of-dandelions-and-daisies/basics-of-mechatronics/mechanical/CAD/Final/kcd4_v1.jpg

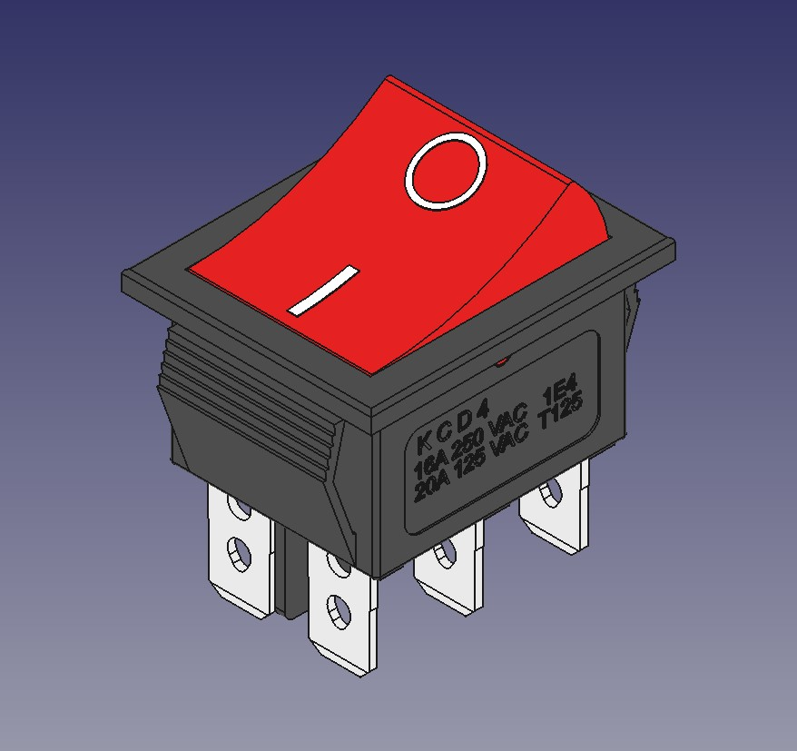
mechanical/CAD/Final/kcd4_v1.jpg
