of-dandelions-and-daisies/basics-of-mechatronics/app/README.md

# App

Processing IO application for the mechatronics project.
