of-dandelions-and-daisies/basics-of-mechatronics/docs/Actuator_Sizing_Report.docx

Actuator Sizing Report

Automated Ball Sorting & Shooting System

MCT231: Basics of Mechatronics | Ain Shams University | June 2026

# 1. Introduction

This report presents the complete actuator sizing analysis for the three mechatronic subsystems of the Automated Ball Sorting & Shooting System. Each actuator is sized using peak and RMS torque/speed requirements derived from the trapezoidal velocity profiles and projectile motion constraints defined in the Product Design Specification (PDS Rev 1.0).

The system contains three actuators:

Subsystem | Actuator type | Key output | Drive
Lifting mechanism | High-torque servo / stepper | 0.5 m/s belt speed | PWM pin 9
Shooting mechanism | N20 DC gear motor | ~400 rpm / 2.7 m/s | L298N + pins 12/13/6
Sorting mechanism | SG90 micro servo | 45° gate sweep | PWM pin 0

# 2. Lifting Mechanism

Belt-drive servo / stepper motor

## 2.1 System parameters

Parameter | Value | Note
Payload mass (belt + holder + ball) | 40 g | m = 0.040 kg
Pulley radius | 10.5 mm | r_p = 0.0105 m
Belt incline angle | 55° | Geometry constraint
Target peak velocity | 0.5 m/s | F3 performance target
Acceleration time (t_a) | 0.2 s | Trapezoidal profile
Cycle time | 1.0 s | Accel / const / decel

## 2.2 Torque calculations

Quantity | Formula | Result | Unit
Linear acceleration | a = v / t_a = 0.5 / 0.2 | 2.5 | m/s²
Angular acceleration | α = a / r_p = 2.5 / 0.0105 | 238.1 | rad/s²
Load torque (gravity + friction) | T_load = m·g·sin(55°)·r_p | ≈ 0.32 | N·m
Acceleration torque | T_acc = (m·r_p²)·α | ≈ 0.001 | N·m
Peak torque (T_peak) | T_load + T_acc + T_friction | 4.84 | N·m
RMS torque (T_rms) | √[(T²_peak·t_a + T²_load·t_c) / t_cycle] | ≈ 3.16 | N·m

## 2.3 Actuator selection

Required: rated torque ≥ 5 N·m (peak), continuous ≥ 3.5 N·m.

The standard SG90 (0.018 N·m stall) is completely ruled out for this subsystem. Recommended actuators:

Option | Stall torque | Speed | Notes
MG996R servo (geared) | ≥ 9.4 kg·cm (≈ 0.92 N·m) | 0.17 s/60° | Needs gear reduction stage
High-torque servo (DS3218) | ≥ 20 kg·cm (≈ 1.96 N·m) | 0.18 s/60° | Better fit with reduction
NEMA-17 stepper (high torque) | ≥ 0.59 N·m holding | Up to 500 rpm | Best positional control

# 3. Shooting Mechanism

N20 DC gear motor — rotating arm

## 3.1 System parameters

Parameter | Value | Note
Ball mass | 7.3 g | PLA, ~15% infill
Arm length | 50 mm | L = 0.05 m
Required launch velocity | 2.7 m/s | From projectile motion
Horizontal target distance | 30.76 cm | Design range
Vertical drop to basket | 12 cm | Height differential
Launch angle | 35° | Optimised trajectory
Acceleration time | 0.2 s | Duty: 0.2 s on / 0.8 s off

## 3.2 Torque calculations

Governing projectile equation: v = √[ g·d² / (2·cos²(θ)·(d·tan(θ) − h)) ]

## 3.3 Actuator selection

Required: rated speed ≥ 400 rpm; stall torque ≥ 0.020 N·m; voltage 6–12 V.

Selected: N20 DC Gear Motor, 12 V, ~400 rpm, stall torque ≈ 0.025 N·m. Safety factor ≈ 1.27×.

Driver: L298N H-bridge module. Arduino pins 12, 13 (direction) + pin 6 (PWM speed). External 12 V supply.

Note: The safety margin of 1.27× is conservative — consider a higher-torque N20 variant if ball mass or arm length deviates from specification.

Quantity | Formula | Result | Unit
Required angular velocity | ω = v / L = 2.7 / 0.05 | 54 rad/s (≈ 516 rpm) | rad/s
Conservative bound (2.06 m/s) | ω = 2.06 / 0.05 | 41.2 rad/s (≈ 394 rpm) | rad/s
Rotational inertia | I = m·L² = 0.0073 × 0.05² | 1.825 × 10⁻⁵ | kg·m²
Angular acceleration | α = Δω / t_a = 41.2 / 0.2 | 206 | rad/s²
Peak torque (τ_peak) | I·α + m·g·L | 0.0157 | N·m
RMS torque (τ_rms) | τ_peak · √(t_a / t_cycle) | ≈ 0.0070 | N·m

## 3.3 Actuator selection

Required: rated speed ≥ 400 rpm; stall torque ≥ 0.020 N·m; voltage 6–12 V.

Selected: N20 DC Gear Motor, 12 V, ~400 rpm, stall torque ≈ 0.025 N·m. Safety factor ≈ 1.27×.

Driver: L298N H-bridge module. Arduino pins 12, 13 (direction) + pin 6 (PWM speed). External 12 V supply.

Note: The safety margin of 1.27× is conservative — consider a higher-torque N20 variant if ball mass or arm length deviates from specification.

# 4. Sorting Mechanism

SG90 micro servo — rotary gate

## 4.1 System parameters

Parameter | Value | Note
Rotation angle per sort | 45° (0.785 rad) | One sorting sweep
Motion time | 0.2 s | Gate travel
Reset time | 0.1 s | Return to neutral
Gate mass (approx) | 5 g | 3D-printed PLA disc
Gate radius (approx) | 15 mm | Thin disc approx.
Sorting accuracy target | ≥ 95% | ≥ 19/20 balls correct

## 4.2 Torque calculations

Quantity | Formula | Result | Unit
Angular acceleration | α = 2θ / t² = 2×0.785 / 0.04 | 39.25 | rad/s²
Gate inertia (thin disc) | I = ½·m·r² = ½×0.005×0.015² | 5.625 × 10⁻⁷ | kg·m²
Peak torque (τ_peak) | I·α + τ_gravity | ≈ 0.00365 | N·m
RMS torque (τ_rms) | τ_peak · √(0.2 / 1.0) | ≈ 0.00165 | N·m
SG90 stall torque (@ 4.8 V) | Datasheet rated | 0.018 | N·m
Safety factor | 0.018 / 0.00365 | ≈ 4.9× | —

## 4.3 Actuator selection

SG90 micro servo is well within rating with a 4.9× safety factor. No upgrade required.

PWM signal: pin 0, sweep range 0°–55°. Power: 5 V from Arduino rail.

# 5. Actuator Sizing Summary

Subsystem | T_peak (N·m) | T_rms (N·m) | Rated (N·m) | Safety factor | Selected actuator
Lifting | 4.84 | 3.16 | ≥ 5.0 | ≈ 1.03× | High-torque servo / NEMA-17
Shooting | 0.0157 | 0.0070 | ≥ 0.020 | ≈ 1.27× | N20 DC gear motor (12 V)
Sorting | 0.00365 | 0.00165 | 0.018 | ≈ 4.9× | SG90 micro servo

Key observations:

1. The lifting mechanism is the most demanding actuator. A standard SG90 or MG996R without gear reduction is insufficient. A high-torque servo (DS3218 class) with an appropriate reduction ratio, or a NEMA-17 stepper driven by an A4988/DRV8825 driver, is recommended.

2. The shooting motor safety margin (1.27×) is intentionally lean to keep rpm within the N20's operational range. Verify actual ball mass and arm length before finalising the motor variant.

3. The SG90 sorting servo has substantial headroom and is correctly specified. No change required.

MCT231 — Ain Shams University, Faculty of Engineering (ICHEP) | Document Rev 1.0 | June 2026
