of-dandelions-and-daisies/basics-of-mechatronics/docs/MCT231_SpongeBob_Mechatronics.pptx

MCT231 · BASICS OF MECHATRONICS

SpongeBob Educational Toy

A Fully Automated Mechatronic System

Ain Shams University · ICHEP · Final Submission

Ahmed Mohamed Taha · Nada Abdelhamid · Mohamed Samy Taha · Rawaa Tarig Algadi · Farida Mohamed Saeed

## Slide 2

PROJECT OVERVIEW

A fully automated SpongeBob-themed educational toy combining ball dispensing, lifting, shooting, and sorting with a closed-loop mechatronic control system. Children learn color recognition through an interactive Q&A game while the system autonomously handles every ball cycle.

🎯 Color Recognition Game

Children identify ball colors using push buttons. LCD prompts the question; buzzer gives feedback.

🔄 Closed-Loop Control

IR sensors + optical encoder provide continuous feedback for reliable, automated operation.

📡 Bluetooth GUI

HC-06 module enables wireless monitoring & control from a PC. Two Arduino Nanos via I²C.

⚙️ Full Ball Lifecycle

Dispense → Lift → Shoot → Sort → Return. Complete cycle in ≤ 2.0 seconds per ball.

## Slide 3

SYSTEM ARCHITECTURE

Dual-controller distributed design with sense–process–actuate architecture

MASTER NANO 1

🎮 Game logic & scoring

💬 LCD display (16×2 I²C)

📡 HC-06 Bluetooth GUI

🔘 Pink & Yellow buttons

🔔 Buzzer feedback

📤 Dispenser servo (IR)

SLAVE NANO 2

⬆️ Lifting servo mechanism

🏀 Shooting DC motor (L298N)

📊 Optical encoder (PID)

🔃 Sorting servo gate

📍 IR Sort Low / High

📍 IR Shooting sensor

I²C

⚡ 12V Li Battery → Buck Converter → 5V (logic / servos) | 12V direct → DC Motor + L298N

## Slide 4

HOW IT WORKS

Ball Dispense

Servo releases one ball when IR sensor confirms presence

1

Color Question

LCD prompts child to identify the ball's color (pink/yellow)

2

Lift Mechanism

Belt-drive servo elevates ball at 0.5 m/s to shoot rail

3

PID Shoot

N20 motor launches ball at ≈2.7 m/s, 35° angle, 30cm range

IR Sort

Dual IR sensors classify ball → servo gate opens left or right

Ball Return

Ball slides to correct bin and returns to dispenser. Cycle ≤ 2.0s

4

5

6

## Slide 5

ACTUATOR SIZING

Engineering calculations for three core mechanisms

Lifting Mechanism

High-Torque Servo / NEMA-17

Safety Factor ≈1.03×

Payload mass

Belt incline

Peak torque

RMS torque

Peak velocity

Standard SG90 ruled out — requires DS3218 or NEMA-17 with driver

Shooting Mechanism

N20 DC Gear Motor (12V)

Safety Factor ≈1.27×

Ball mass

Arm length

Required ω

Peak torque

RMS torque

Safety margin 1.27×. Verify ball mass before finalizing.

Sorting Mechanism

SG90 Micro Servo

Safety Factor ≈4.9×

Rotation angle

Motion time

Peak torque

RMS torque

SG90 rated

Well within rating. No upgrade required.

40 g

7.3 g (PLA)

45° sweep

55°

4.84 N·m

50 mm

394–516 rpm

0.2 s

0.00365 N·m

3.16 N·m

0.0157 N·m

0.00165 N·m

0.5 m/s

0.0070 N·m

0.018 N·m

## Slide 6

PROJECTILE MOTION CALCULATIONS

v = √[ (g · d²) / (2 · cos²(θ) · (d · tan(θ) − h)) ]

Given Parameters

Horizontal distance (d)

Vertical drop (h)

Launch angle (θ)

Gravity (g)

tan(35°)

cos(35°)

Results

Required Launch Velocity

Optimal Launch Angle

RMS Velocity (continuous duty)

30.76 cm

2.7 m/s

12 cm

35°

35°

9.81 m/s²

≈ 0.700

≈ 0.819

1.21 m/s

## Slide 7

ELECTRONICS & CONTROL

SENSORS

IR_Dispenser

Ball presence at gate

IR_Box

Arrival detection

IR_Shooting

Ball at launch cup

IR_Sort Low

Color bit LOW

IR_Sort High

Color bit HIGH

Optical Encoder

Motor speed (PID)

ACTUATORS

SG90 × 2

Sorting + Dispenser servos

DS3218 / NEMA-17

Lifting mechanism

N20 (12V, 400rpm)

Shooting DC motor

L298N H-Bridge

Motor driver module

16×2 I²C LCD

Display & user feedback

Buzzer

Sound feedback

TIMING BUDGET

Sort + classify

Gate reset

Lift to rail

Motor shoot

Motor reset

Total cycle

0.2 s

0.1 s

0.4 s

0.2 s

0.1 s

≤ 2.0 s

## Slide 8

PERFORMANCE SPECIFICATIONS

≥95%

Sorting Accuracy

≥ 19/20 balls correct

≤2.0s

Cycle Time

Detection → Launch

<5cm

Shot Variance

Landing repeatability

<50ms

IR Response

Ball detection latency

Parameter | Value | Notes
Sorting gate precision | ±5° | Rotary gate alignment
Launch velocity | ≈ 2.7 m/s | At 35° launch angle
Lifting peak velocity | 0.5 m/s | Belt drive peak speed
Lifting peak torque | 4.84 N·m | Trapezoidal velocity profile
Footprint | ≤ 600×600 mm | Compact desktop use
System weight | < 1.5 kg | Portability target
Budget | < 5,000 EGP | Prototype cost cap

## Slide 9

INTEGRATION TESTING PLAN

Each subsystem must pass unit tests before full integration proceeds

IR Sensor Detection

✓ Ball detected within 50 ms | Oscilloscope / Serial Monitor

Shooting Accuracy

✓ Ball lands within 5 cm of target | 10-shot grouping test

T1

T5

Color Classification

✓ ≥ 19/20 balls correctly sorted | Manual run of 20 balls

Full Cycle Integration

✓ Cycle ≤ 2.0 s; zero jams | End-to-end timed × 10

T2

T6

Sorting Gate Rotation

✓ Gate reaches ±5° of target | Protractor + servo feedback

T3

Repeated Operation

✓ 50 consecutive cycles OK | Endurance run

T7

Lifting Mechanism

✓ Ball reaches top rail ≤ 0.4 s | Stopwatch timing

T4

## Slide 10

BILL OF MATERIALS

# | Component | Qty | Subsystem | Notes

1 | Arduino Nano | 2 | Control | Master (I²C, BT, LCD) + Slave (lift/shoot/sort)
2 | SG90 Micro Servo | 2 | Sorting + Dispenser | PWM-controlled, 4.9× safety factor
3 | High-Torque Servo / NEMA-17 | 1 | Lifting | DS3218 class or NEMA-17 + driver
4 | N20 DC Gear Motor (12V) | 1 | Shooting | ~400 rpm, stall ≈ 0.025 N·m
5 | L298N H-Bridge Module | 1 | Motor Driver | 12V motor / 5V logic
6 | IR Obstacle Sensors | 5 | Sensing | Dispenser, Box, Shooting, Sort Low/High
7 | Optical Encoder | 1 | Feedback | Speed feedback for PID control
8 | HC-06 Bluetooth Module | 1 | Comms | Wireless PC GUI
9 | 16×2 I²C LCD | 1 | Display | Game prompts & feedback
10 | PLA Filament (~200g) | 1 roll | Structure | Frame, arm, gate, pulleys, balls
11 | 12V Li Battery + Buck Converter | 1 | Power | Dual-rail: 12V motor / 5V logic

Estimated total cost: < 5,000 EGP

## Slide 11

TEAM CONTRIBUTIONS

Ahmed Mohamed Taha

Shooting mechanism design, projectile motion calculations, actuator sizing

24P0050

20%

Nada Abdelhamid

Lifting mechanism design, GUI development, system integration, LCD programming

2301102

20%

Mohamed Samy Taha

Software & hardware fabrication, assembly, dispenser mechanism design

24P0373

20%

Rawaa Tarig Algadi

PCB design, wiring diagrams & Arduino programming

2101367

20%

Farida Mohamed Saeed

Sorting mechanism design, Arduino & PID programming, CAD designs & assembly

24P0008

20%

## Slide 12

CONCLUSION

✅ Successfully integrated mechanical, electrical, and software subsystems into one cohesive mechatronic product

🎮 Interactive color-recognition game demonstrates how mechatronics supports real educational objectives

🔄 Closed-loop PID control + sensor feedback ensures reliable autonomous operation every cycle

📡 Dual Arduino Nano architecture (I²C + Bluetooth) delivers modularity and wireless monitoring

🏗️ Completed within a 5,000 EGP budget using 3D-printed PLA/TPU structure on a 600×600mm base

MCT231 · Ain Shams University · ICHEP · 2025
