of-dandelions-and-daisies/basics-of-mechatronics/docs/PDS_Ball_Sorting_Shooting_System.docx

MCT231: Basics of Mechatronics

Faculty of Engineering — Ain Shams University (ICHEP)

PRODUCT DESIGN SPECIFICATIONS (PDS)

Automated Ball Sorting & Shooting System

Interactive Mechatronic Kids Toy

# | Team Member | Student ID

1 | Ahmed Mohamed Taha | 24P0050
2 | Nada Abdelhamid | 2301102
3 | Mohamed Samy Taha | 24P0373
4 | Rawaa Tarig Algadi | 2101367
5 | Farida Mohamed Saeed | 24P0008

Date: June 2026 | Document Rev: 1.0

# 1. Product Purpose & Overview

This Product Design Specification (PDS) defines all functional, physical, electronic, and safety requirements for the Automated Ball Sorting and Shooting System — an interactive mechatronic toy developed as part of the MCT231 Basics of Mechatronics major project at Ain Shams University.

The system automates the complete lifecycle of a ball from dispenser entry to sorted launch: detecting each ball via IR sensors, classifying it by color, routing it through a sorting gate, elevating it via a belt-driven lifting mechanism, and finally launching it toward a target basket using a rotating-arm shooting mechanism.

## 1.1 Project Vision

To design a safe, engaging, and durable interactive toy that demonstrates real-world closed-loop mechatronic control — merging mechanical precision, embedded electronics, and automated feedback in a compact desktop form factor.

## 1.2 Intended Users

Primary users are children (supervised play). Secondary users include engineering students and educators demonstrating mechatronic integration concepts.

# 2. Functional Requirements

## 2.1 Core Functions

ID | Function | Description | Performance Target
F1 | Ball Detection | IR sensors detect ball presence at the sorting gate | Response < 50 ms
F2 | Color Sorting | IR dual-sensor pair classifies ball (orange / gray) and actuates rotary gate | Sorting accuracy ≥ 95%
F3 | Vertical Lifting | Belt-drive mechanism elevates ball to launch height | Height: target rail level
F4 | High-Velocity Launch | Rotating arm releases ball at calculated velocity toward basket | Range: 30–35 cm
F5 | Ball Return | Ball returns to dispenser after landing for repeated cycles | < 2.0 s cycle time
F6 | Feedback | LED/sound signals indicate successful hits | Immediate (< 200 ms)

## 2.2 Performance Specifications

Parameter | Value | Notes
Sorting gate precision | ±5° | Rotary gate alignment with exit tracks
Total cycle time | ≤ 2.0 s / ball | Detection → launch
Launch landing variance | < 5 cm | Shot repeatability
Required launch velocity | ≈ 2.7 m/s | At 35° launch angle
RMS launch velocity | ≈ 1.21 m/s | Continuous duty cycle
Lifting target velocity | 0.5 m/s | Belt drive peak speed
Lifting peak torque | 4.84 N·m² | Trapezoidal velocity profile
Lifting RMS torque | ≈ 3.16 N·m² | 1.0 s cycle

# 3. Physical & Dimensional Constraints

Constraint | Specification | Rationale
Footprint | ≤ 600 mm × 600 mm | Compact desktop use (per CAD assembly)
Total system weight | < 1.5 kg | Portability
Ball radius | 18 mm | PLA, ~15% infill, ≈ 7.3 g
Pulley radius | 10.5 mm | Belt-drive lifting pulley
Arm length (shooting) | 50 mm | Rotating arm projectile release
Belt incline angle | 55° | Lift mechanism geometry
Primary material | PLA / TPU (3D printed) | Rapid prototyping, low cost, child-safe

# 4. Electronic & Control Specifications

## 4.1 Microcontroller

Arduino Uno / Nano used as the central controller. It receives digital signals from IR sensors, outputs PWM signals to servo motors, and drives the DC motor via an H-bridge module.

## 4.2 Sensors

Sensor | Type | Function
Ball Detection Sensor | IR Obstacle Avoidance (digital) | Detects ball arrival at sorting station
Color Sensor (pair) | Dual IR proximity sensors (Low/High pins) | Distinguishes orange vs. gray balls for routing

## 4.3 Actuators

Actuator | Type | Output | Role
Sorting Servo | SG90 Micro Servo | 45° rotation | Rotary gate redirects ball by color
Lifting Servo/Stepper | High-torque servo or stepper | 0–90° / steps | Belt-drive pulley for vertical elevation
Shooting Motor | N20 DC Gear Motor | ~400 rpm / ≈2.7 m/s | Drives rotating arm for ball launch

## 4.4 Motor Driver

L298N or L293D dual H-bridge module. Input: PWM signals from Arduino. Output: variable voltage to DC motor. Separate 12 V supply for motor power; 5 V logic from Arduino.

## 4.5 Power Supply

Dual-rail supply: 5 V for logic/servos (USB or regulated supply), 12 V for DC shooting motor (external battery pack or adapter). Total estimated current draw < 2 A under peak load.

# 5. Actuator Sizing Summary

## 5.1 Lifting Mechanism

Parameter | Value | Formula / Note
Total payload mass | 40 g | Belt (30 g) + holder + ball (10 g)
Linear acceleration | 2.5 m/s² | v/t_a = 0.5/0.2
Angular acceleration | 238.1 rad/s² | a / r_p
Peak torque (T_peak) | 4.84 N·m² | T_load + T_friction + T_acc
RMS torque (T_rms) | ≈ 3.16 N·m² | Trapezoidal profile, 1.0 s cycle

## 5.2 Shooting Mechanism (Rotating Arm)

Parameter | Value | Formula / Note
Required release velocity | ≈ 2.06 m/s | Projectile motion to 30 cm range
Angular velocity | 41.2 rad/s (≈ 394 rpm) | v / L
Peak torque (τ_peak) | 0.0157 N·m | τ_inertia + τ_gravity
RMS torque (τ_rms) | ≈ 0.0070 N·m | 0.2 s accel / 1.0 s cycle

## 5.3 Sorting Mechanism (Rotary Gate)

Parameter | Value | Formula / Note
Rotation angle | 45° (0.785 rad) | One sorting sweep
Angular acceleration | 39.25 rad/s² | 2θ / t²
Peak torque (τ_peak) | 0.00365 N·m | τ_inertia + τ_gravity
RMS torque (τ_rms) | ≈ 0.00165 N·m | 0.2 s motion / 1.0 s cycle

# 6. Projectile Motion Calculations

Parameter | Value | Note
Horizontal target distance (d) | 30.76 cm | Design target range
Vertical drop to basket (h) | 12 cm | Height differential
Launch angle (θ) | 35° | Optimized for stable curved path
Required initial velocity (v) | ≈ 2.7 m/s | From projectile equation
RMS velocity (V_rms) | ≈ 1.21 m/s | Continuous thermal load (1.0 s duty)

Governing equation: v = √[ (g · d²) / (2 · cos²(θ) · (d · tan(θ) − h)) ]

# 7. Safety & Quality Standards

Category | Requirement
Rotating parts | High-speed rotating components (shooting arm, belt pulleys) must be partially shielded to prevent accidental contact
Structural stability | Base must be weighted or suctioned to prevent tipping during high-acceleration launch phases
Projectile safety | Low-velocity launch (< 3 m/s); soft PLA balls only; no sharp edges
Electrical safety | All high-voltage connections enclosed; USB/DC input only; no exposed mains wiring
Budget constraint | Prototype component cost ≤ 5,000 EGP
Material safety | Primary structure 3D-printed in PLA/TPU; child-safe, non-toxic

# 8. System Integration

System integration is the process of combining all independently designed subsystems — mechanical, electronic, and software — into a single cohesive and functional unit. For this project, integration bridges four distinct domains: the sorting mechanism, the lifting mechanism, the shooting mechanism, and the Arduino-based control layer.

## 8.1 Integration Architecture

The system follows a sense–process–actuate closed-loop architecture coordinated by a central Arduino Uno:

Layer | Component | Interface | Signal Type
Sense | IR Sensor (detection) | Digital pin (Arduino) | Digital HIGH/LOW
Sense | IR Sensor pair (color) | Digital pins 2 & 4 | Dual-bit color code
Process | Arduino Uno | Central MCU | Logic / PWM generation
Actuate | SG90 Servo (sorting) | PWM pin 0 | 0°–55° position
Actuate | Servo (lifting) | PWM pin 9 | 90°–100° sweep
Actuate | N20 Motor (shooting) | L298N via pins 12/13/6 | PWM speed + direction

## 8.2 Subsystem Sequencing & Timing

The Arduino orchestrates all subsystems in a strict timed sequence within a 2.0-second cycle budget:

Step | Subsystem | Action | Duration | Trigger Condition
1 | Sorting (IR + Servo) | Ball detected → color classified → gate opens to correct lane | 0.2 s | IR sensor goes HIGH
2 | Sorting (Servo reset) | Gate returns to neutral position | 0.1 s | After 1000 ms delay
3 | Lifting (Servo/motor) | Belt drive elevates ball to launch rail height | 0.4 s | After sorting complete
4 | Shooting (N20 motor) | Arm accelerates → releases ball at 2.7 m/s toward basket | 0.2 s | Ball present at launch cup
5 | Motor idle / reset | Motor decelerates; system ready for next ball | 0.1 s | After shoot delay
Total | — | Full ball cycle | ≤ 2.0 s | —

## 8.3 Software Integration (Arduino Control Logic)

The unified Arduino sketch integrates all three subsystem programs (lifting.ino, dc.ino, sortingfinal.ino) into a single sequential control loop:

// Integrated Control Flow (pseudo-code)

void loop() {

int low = digitalRead(sensorLow); // Color IR low bit

int high = digitalRead(sensorHigh); // Color IR high bit

if (low==0 && high==1) { gate.write(0); delay(1000); gate.write(0); } // Small (orange) ball

else if (high==0) { gate.write(55); delay(1000); gate.write(0); } // Large (gray) ball

beltServo.write(100); delay(1000); beltServo.write(90); // Lift

// DC motor shoots → stops (L298N H-bridge logic)

}

## 8.4 Electrical Integration

All subsystems share a common GND. The L298N motor driver receives a dedicated 12 V supply for the shooting motor while drawing 5 V logic from the Arduino. Servo power is supplied via the Arduino 5 V rail (current-limited; external 5 V BEC recommended under full load). Signal routing is managed through a custom PCB designed in Fritzing/EasyEDA.

Component | Power Rail | Signal Pin(s) | Driver/Module
IR Sensors (×2) | 5 V / GND | Pins 2, 4 | Direct to Arduino
SG90 Sorting Servo | 5 V / GND | Pin 0 (PWM) | Direct to Arduino
Belt Drive Servo | 5 V / GND | Pin 9 (PWM) | Direct to Arduino
N20 Shooting Motor | 12 V (motor) / 5 V (logic) | Pins 12, 13, 6 | L298N H-bridge

## 8.5 Mechanical Integration

All subsystems are mounted on a shared 600 mm × 600 mm 3D-printed base plate. The ball track connects the sorting gate exit directly to the lifting mechanism input rail, which feeds the rotating arm cup. Alignment tolerances are maintained within ±2 mm across the track junctions to ensure smooth ball transition without jamming.

Interface Point | Connected Subsystems | Tolerance / Note
Dispenser → Sorting gate | Ball dispenser ↔ IR sensor + rotary gate | Ball channel: ±1 mm alignment
Sorting gate → Lift input | Rotary gate exit ↔ belt drive bottom | Gravity-fed track; slope ≥ 15°
Lift output → Shoot cup | Belt drive top rail ↔ rotating arm cup | Horizontal rail; ±2 mm height
Shoot cup → Basket | Rotating arm ↔ target basket | Projectile path; 30–35 cm free air

## 8.6 Integration Testing Plan

Each subsystem must pass individual unit tests before full integration testing proceeds:

# | Test | Pass Criterion | Method

T1 | IR sensor detection | Ball detected within 50 ms | Oscilloscope / Serial Monitor
T2 | Color classification accuracy | ≥ 19/20 balls correctly sorted | Manual run of 20 balls
T3 | Sorting gate rotation | Gate reaches ±5° of target angle | Protractor + servo feedback
T4 | Lifting mechanism | Ball reaches top rail within 0.4 s | Stopwatch timing
T5 | Shooting accuracy | Ball lands within 5 cm of target | 10-shot grouping test
T6 | Full cycle integration | Complete cycle ≤ 2.0 s; no jams | End-to-end timed run × 10
T7 | Repeated operation | 50 consecutive cycles without failure | Endurance run

# 9. Bill of Materials (Summary)

# | Component | Qty | Subsystem | Notes

1 | Arduino Uno | 1 | Control | Central MCU
2 | SG90 Micro Servo | 2 | Sorting + Lifting | PWM-controlled positioning
3 | N20 DC Gear Motor | 1 | Shooting | ~400 rpm at rated voltage
4 | L298N H-Bridge Module | 1 | Motor Driver | 12 V motor / 5 V logic
5 | IR Obstacle Sensor | 2 | Sensing | Ball detection & color classification
6 | PLA Filament | ~200 g | Structure | Frame, arm, gate, pulleys, balls
7 | TPU Filament | ~50 g | Belt | Flexible belt drive
8 | PCB (custom) | 1 | Electronics | Designed in Fritzing / EasyEDA
9 | Power supply (5 V / 12 V) | 1 | Power | Dual-rail DC adapter or battery
10 | Jumper wires, headers | — | Wiring | Interconnects

Estimated total prototype cost: < 5,000 EGP

CONFIDENTIAL — For academic use only Page

MCT231 Mechatronics — Product Design Specifications Ain Shams University | June 2026
