of-dandelions-and-daisies/basics-of-mechatronics/docs/block diagram.pdf

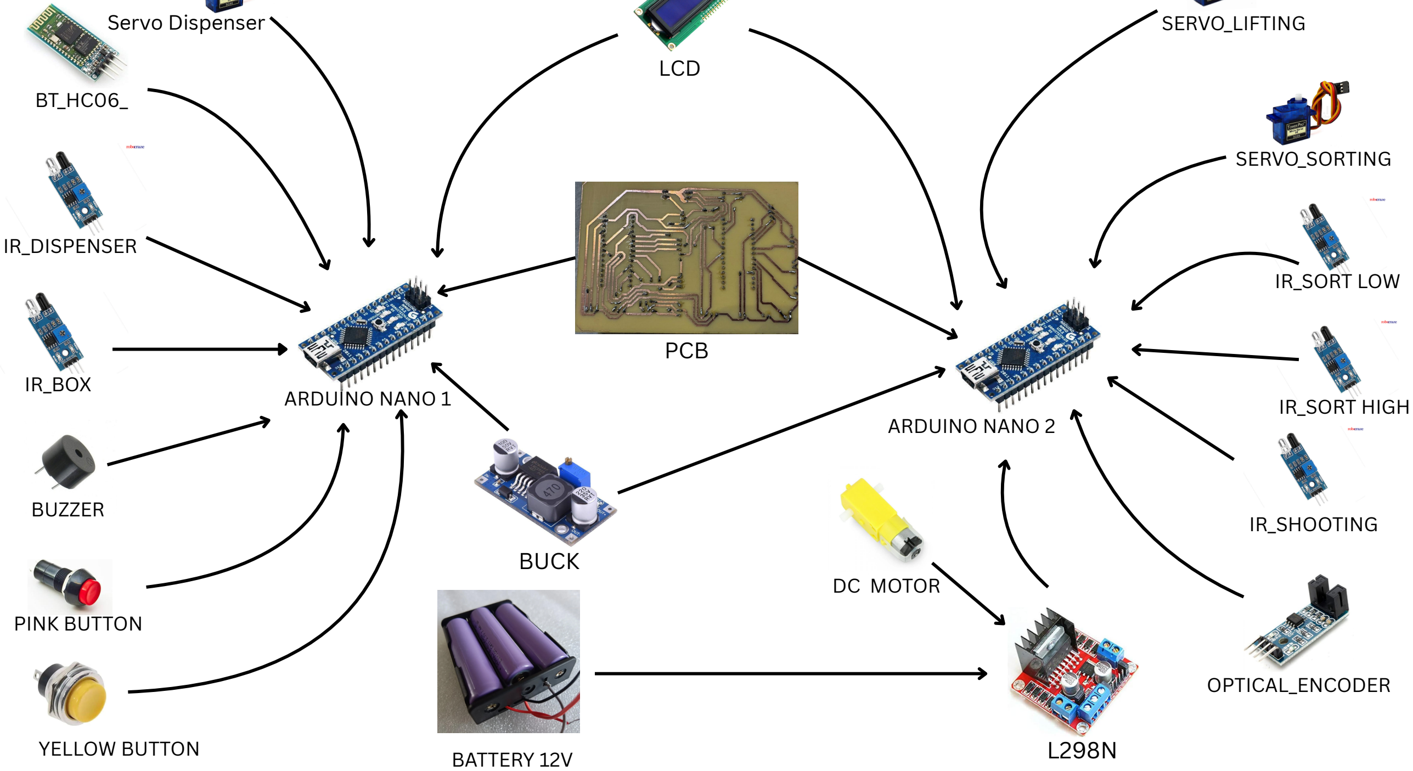
[picture p11: figure]
DC MOTOR; BUCK; Servo Dispenser; IR_DISPENSER; IR_BOX; BUZZER; PINK BUTTON; YELLOW BUTTON; ARDUINO NANO 1; ARDUINO NANO 2; IR_SHOOTING; IR_SORT LOW; IR_SORT HIGH; SERVO_SORTING; SERVO_LIFTING; OPTICAL_ENCODER; BATTERY 12V; LCD; PCB
