of-dandelions-and-daisies/basics-of-mechatronics/docs/gant chart.docx

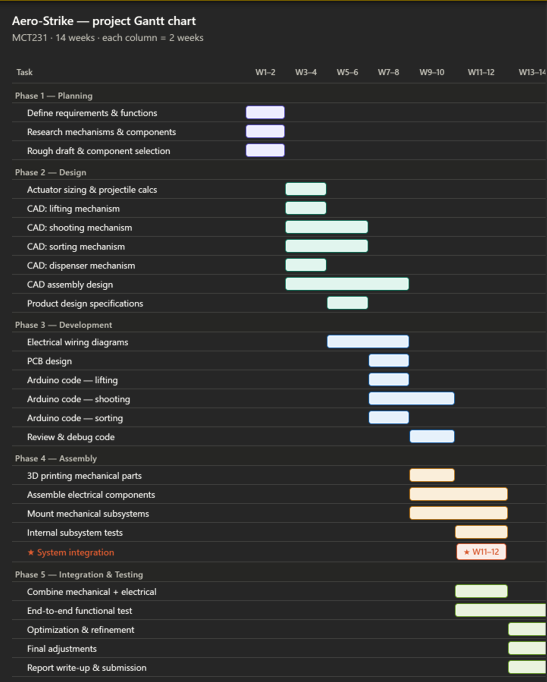
[picture p12: figure]
