of-dandelions-and-daisies/basics-of-mechatronics/docs/flowchart.pdf

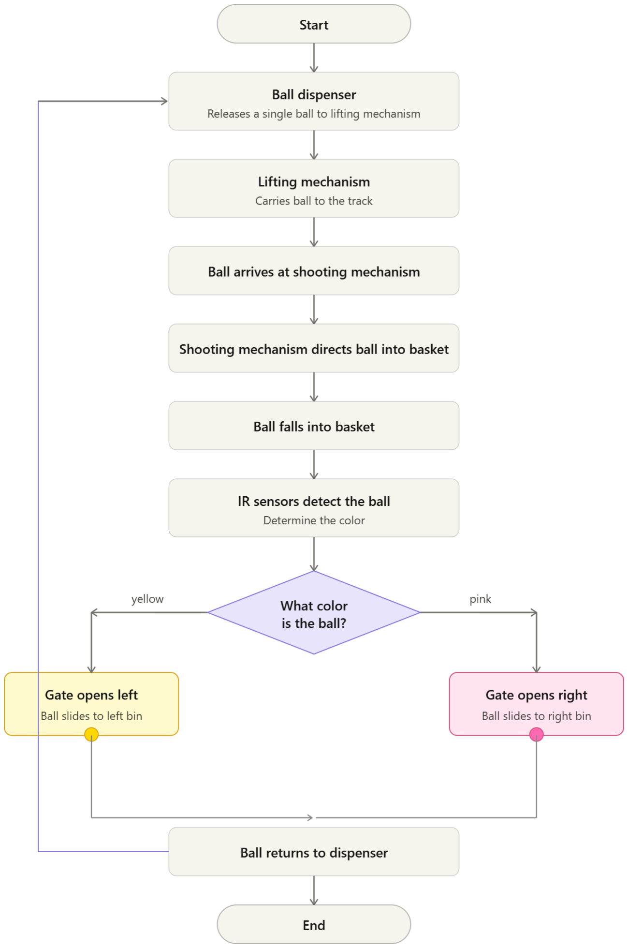
[picture p13: page 1]
