of-dandelions-and-daisies/basics-of-mechatronics/docs/Fancy.png

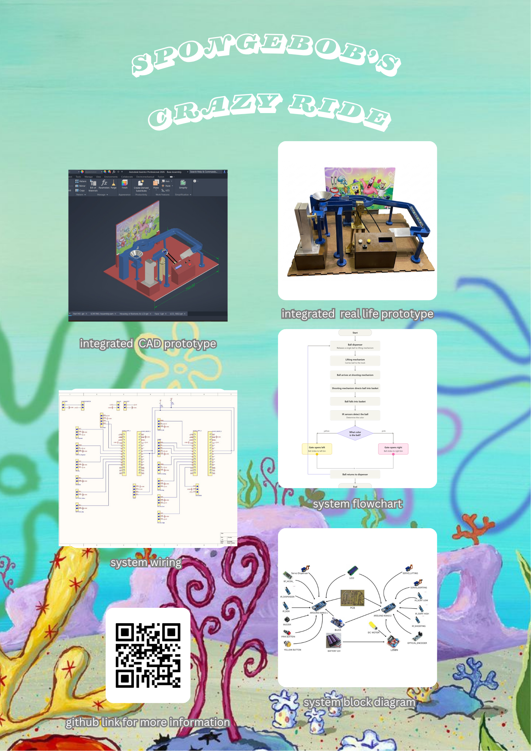
docs/Fancy.png
