of-dandelions-and-daisies/basics-of-mechatronics/mechanical/CAD/Final/kcd4_size.png

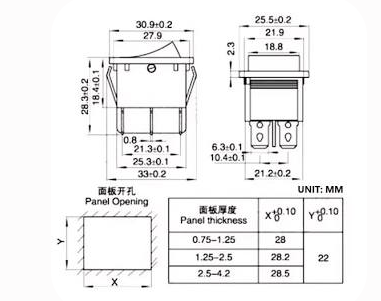
mechanical/CAD/Final/kcd4_size.png
