of-dandelions-and-daisies/basics-of-mechatronics/mechanical/CAD/Final/LCD_1602.JPG

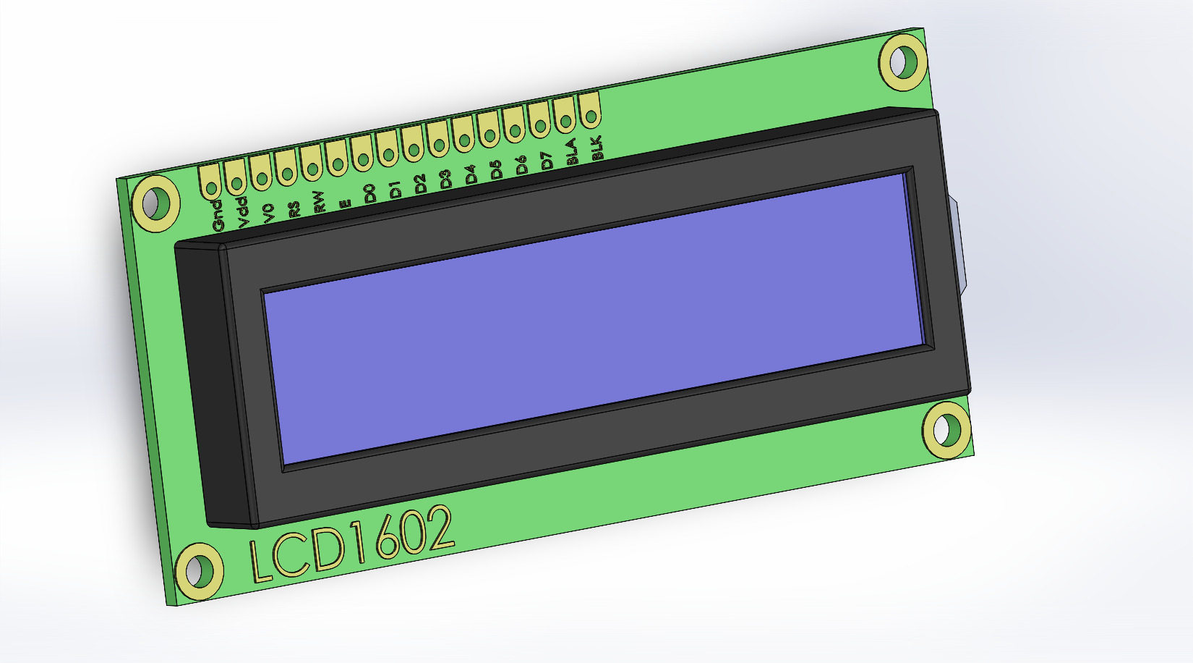
mechanical/CAD/Final/LCD_1602.JPG
