of-dandelions-and-daisies/basics-of-mechatronics/mechanical/CAD/Final/Screenshot 2026-05-28 145023.png

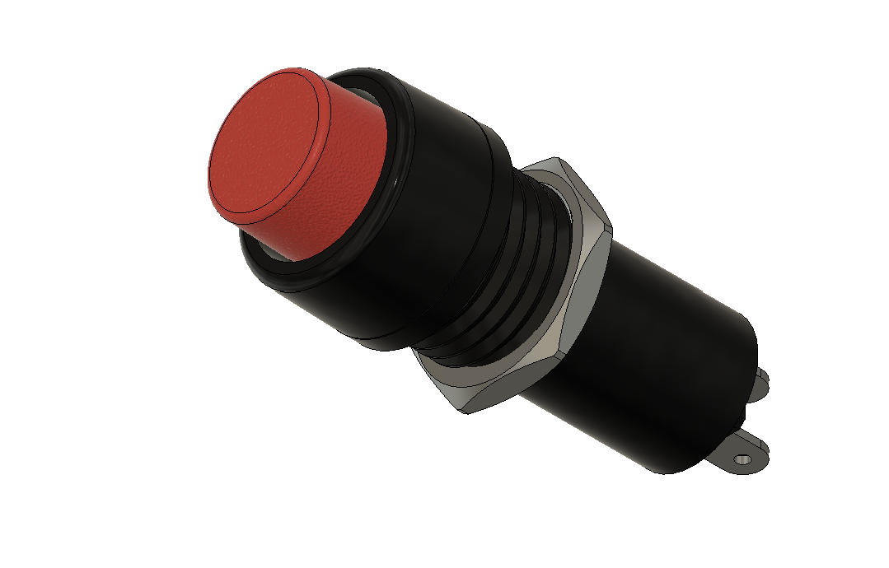
mechanical/CAD/Final/Screenshot 2026-05-28 145023.png
