of-dandelions-and-daisies/basics-of-mechatronics/mechanical/CAD/Final/PushButtonSwitchMainBody.step

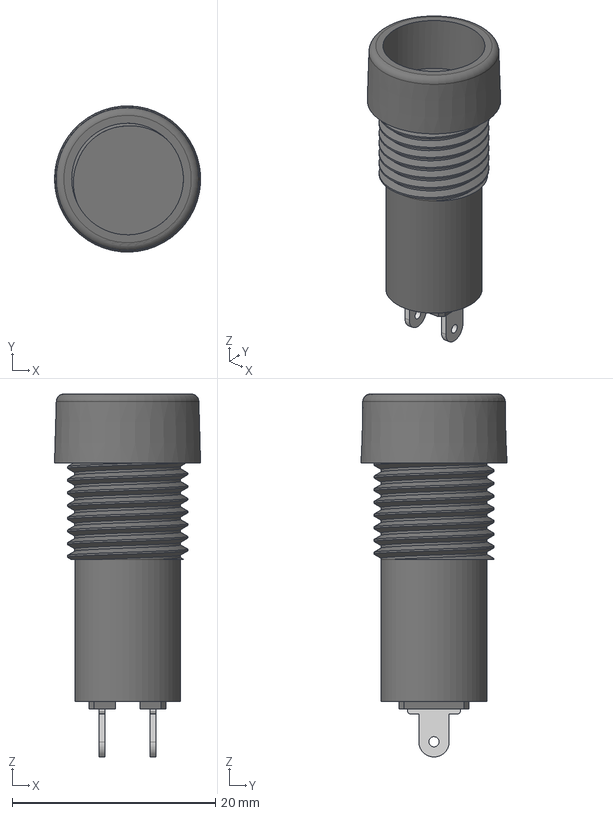
[picture p18: CAD file, 2026-06-11]
mechanical/CAD/Final/PushButtonSwitchMainBody.step
14.4 x 14.4 x 35.8 mm
