of-dandelions-and-daisies/basics-of-mechatronics/mechanical/CAD/Final/encoder disk.STEP

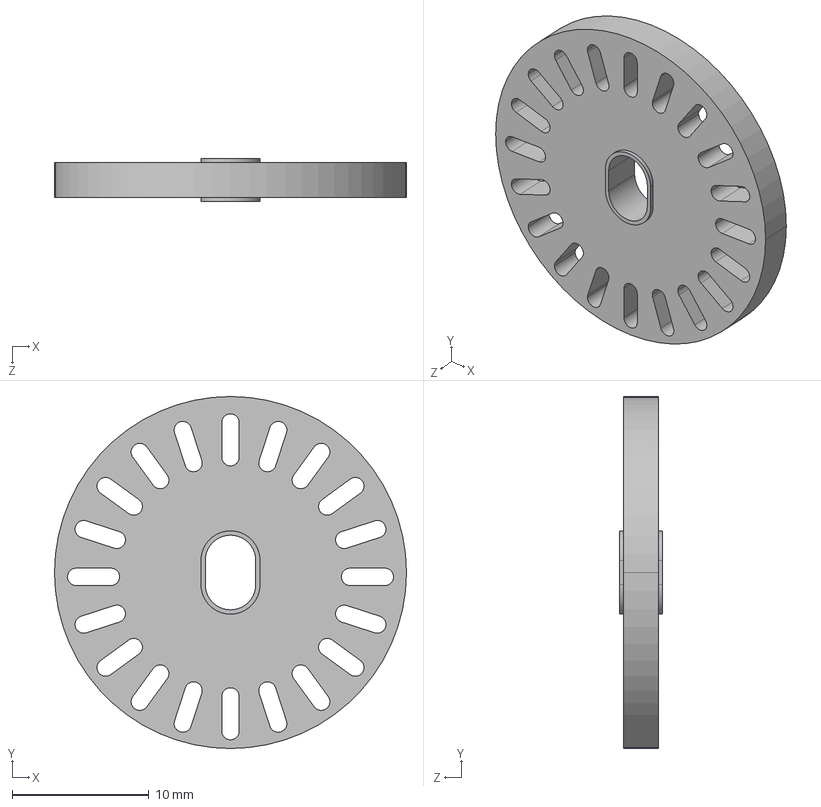
[picture p19: CAD file, 2026-06-11]
mechanical/CAD/Final/encoder disk.STEP
25.8 x 25.8 x 3.18 mm
