of-dandelions-and-daisies/basics-of-mechatronics/mechanical/CAD/Final/basket.stl

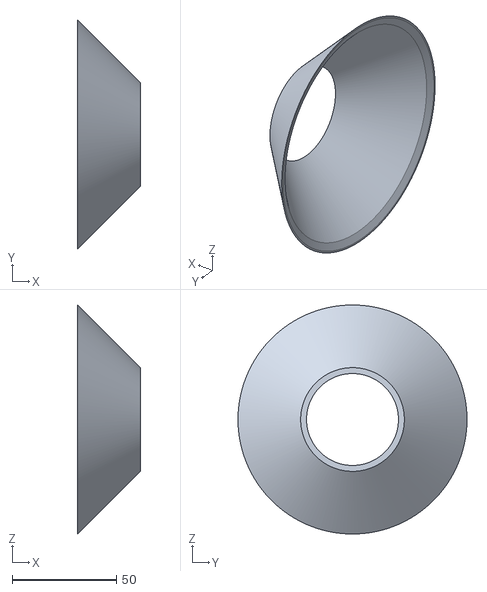
[picture p20: CAD file, 2026-06-11]
mechanical/CAD/Final/basket.stl
30.0 x 109.7 x 109.6
