of-dandelions-and-daisies/basics-of-mechatronics/mechanical/CAD/Final/Cover of DC Housing.stl

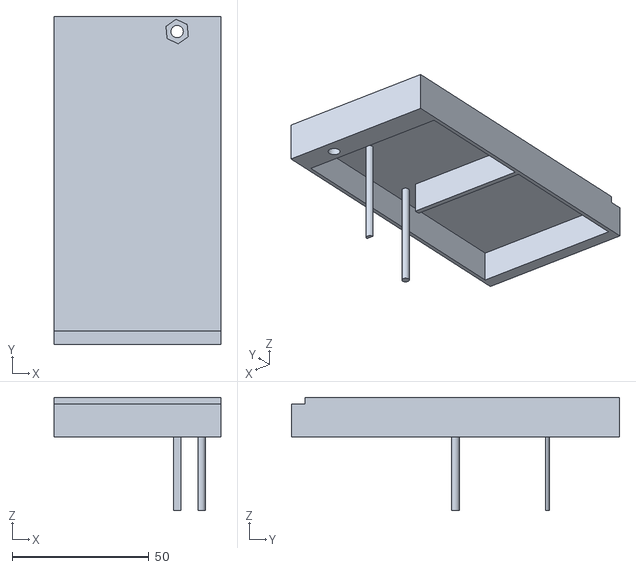
[picture p21: CAD file, 2026-06-11]
mechanical/CAD/Final/Cover of DC Housing.stl
61.0 x 120.0 x 41.5
