of-dandelions-and-daisies/basics-of-mechatronics/mechanical/CAD/Final/Part1#2 .stl

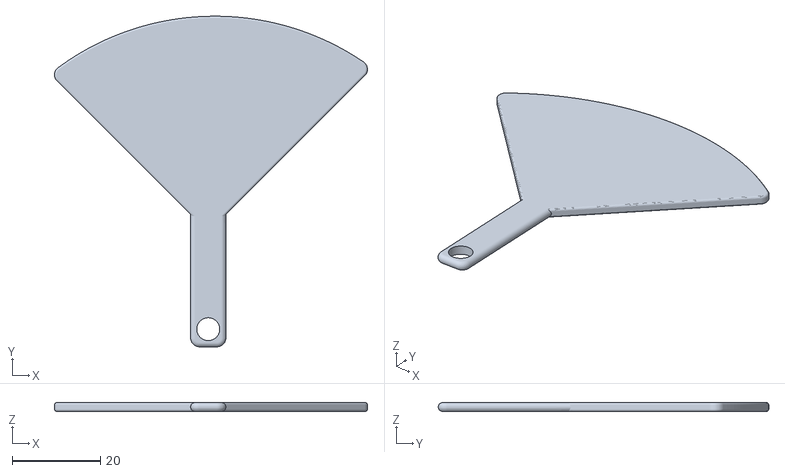
[picture p22: CAD file, 2026-06-11]
mechanical/CAD/Final/Part1#2 .stl
71.0 x 75.0 x 2.00
