of-dandelions-and-daisies/basics-of-mechatronics/mechanical/CAD/Final/IR_LM393.stp

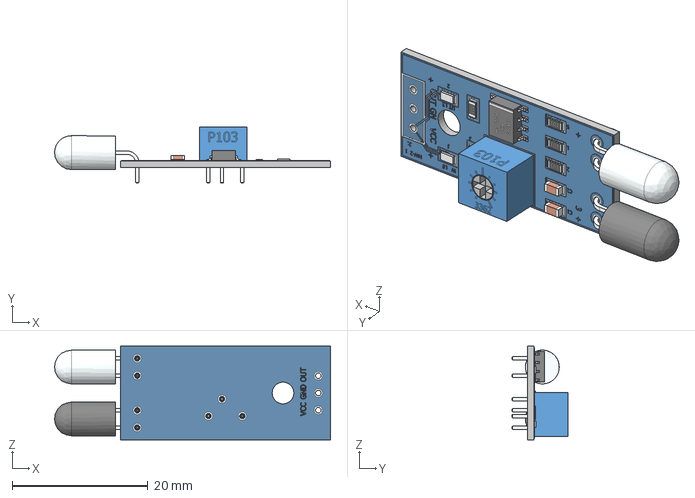
[picture p23: CAD file, 2026-06-11]
mechanical/CAD/Final/IR_LM393.stp
40.7 x 8.31 x 13.8 mm
