of-dandelions-and-daisies/basics-of-mechatronics/mechanical/CAD/Final/KCD4_black.step

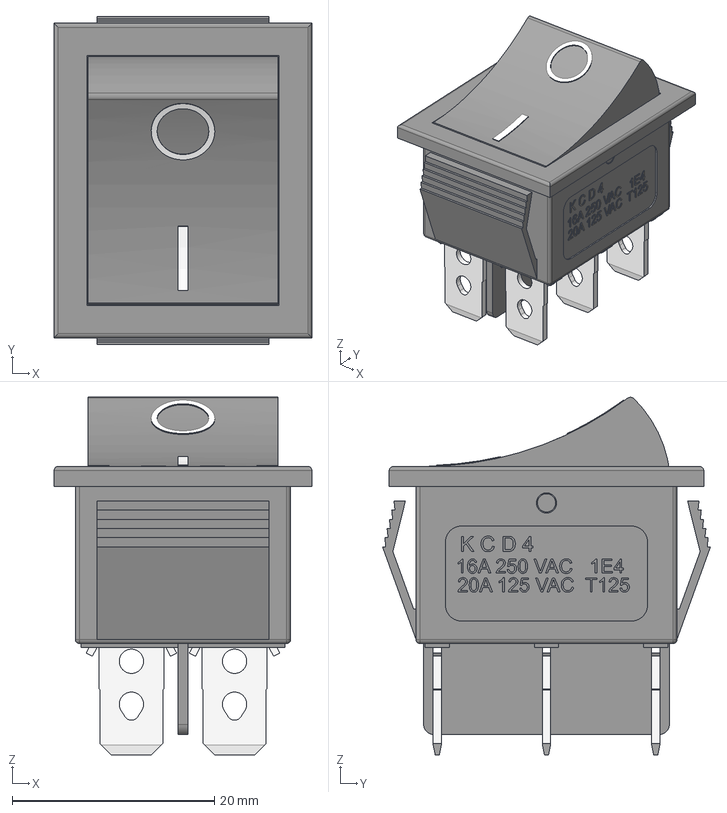
[picture p24: CAD file, 2026-06-11]
mechanical/CAD/Final/KCD4_black.step
25.5 x 32.4 x 35.3 mm
base
rocker
fiche x 6
