of-dandelions-and-daisies/basics-of-mechatronics/mechanical/CAD/Final/IR_LM393_pin.stp

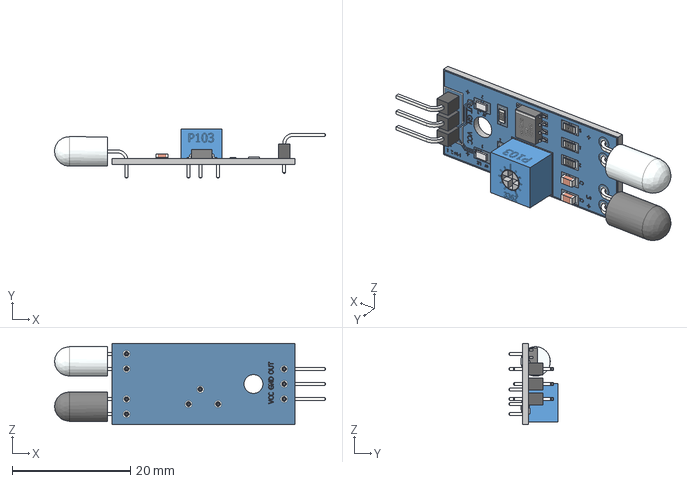
[picture p25: CAD file, 2026-06-11]
mechanical/CAD/Final/IR_LM393_pin.stp
45.9 x 8.31 x 13.8 mm
