of-dandelions-and-daisies/basics-of-mechatronics/mechanical/CAD/Final/Path from Lifting to Shooting.stl

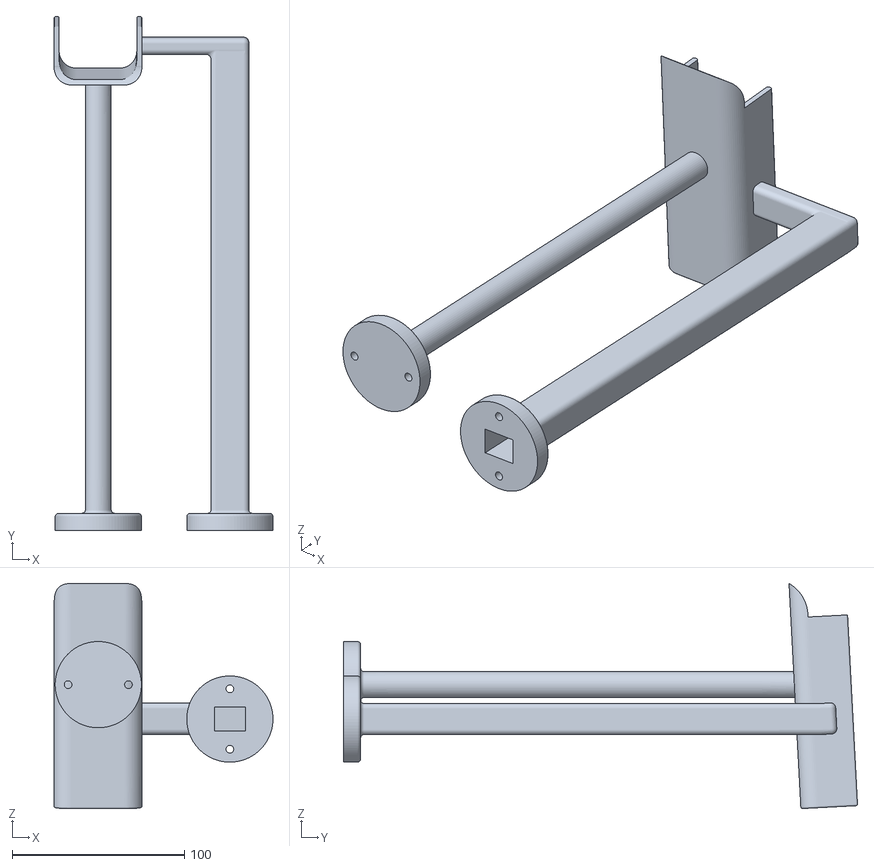
[picture p26: CAD file, 2026-06-11]
mechanical/CAD/Final/Path from Lifting to Shooting.stl
127.0 x 298.1 x 130.6
