of-dandelions-and-daisies/basics-of-mechatronics/mechanical/CAD/Final/Housing of DC Motor.stl

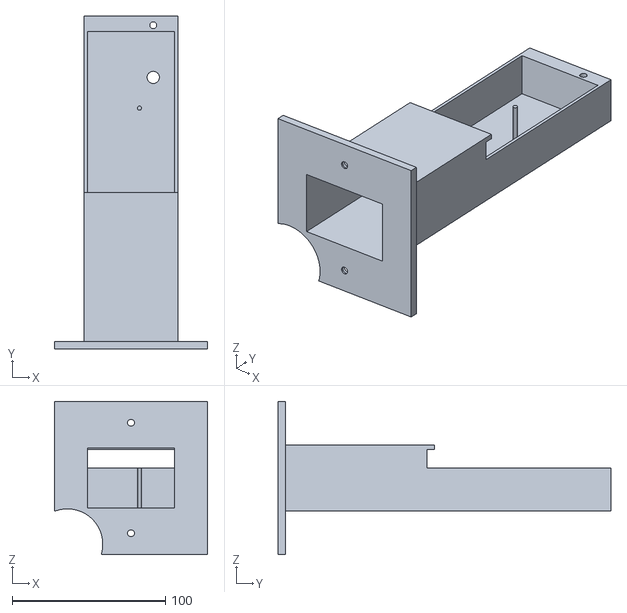
[picture p27: CAD file, 2026-06-11]
mechanical/CAD/Final/Housing of DC Motor.stl
100.0 x 217.0 x 100.0
