of-dandelions-and-daisies/basics-of-mechatronics/mechanical/CAD/Final/DC - Gear Box Motor.step

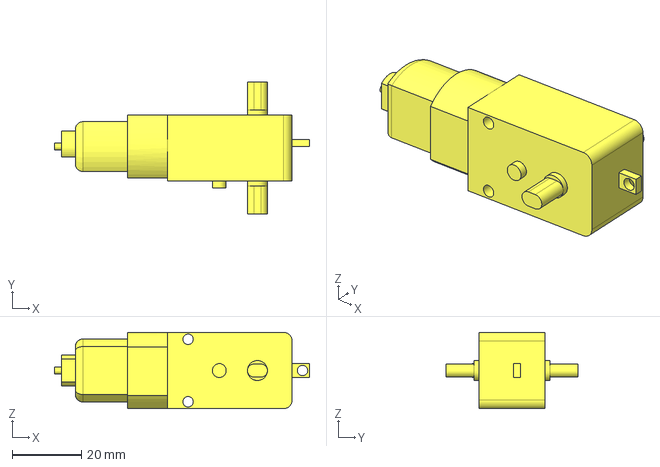
[picture p28: CAD file, 2026-06-11]
mechanical/CAD/Final/DC - Gear Box Motor.step
73.5 x 38.0 x 22.0 mm
