of-dandelions-and-daisies/basics-of-mechatronics/mechanical/CAD/Final/Servo housing.stl

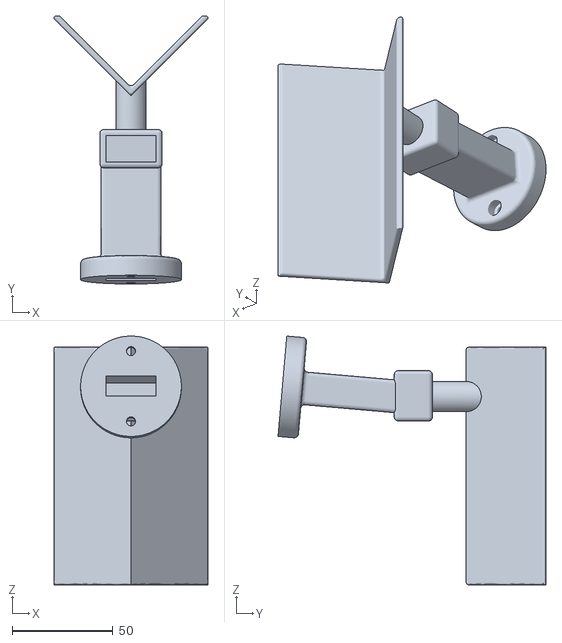
[picture p29: CAD file, 2026-06-11]
mechanical/CAD/Final/Servo housing.stl
76.4 x 133.0 x 123.5
