of-dandelions-and-daisies/basics-of-mechatronics/mechanical/CAD/Final/Gate.stl

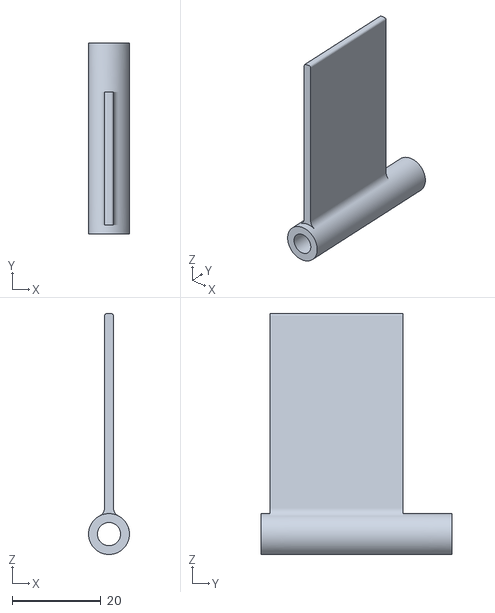
[picture p30: CAD file, 2026-06-11]
mechanical/CAD/Final/Gate.stl
9.20 x 43.0 x 54.2
