of-dandelions-and-daisies/basics-of-mechatronics/mechanical/CAD/Final/00_마이크로 서보_혼 십자.STEP

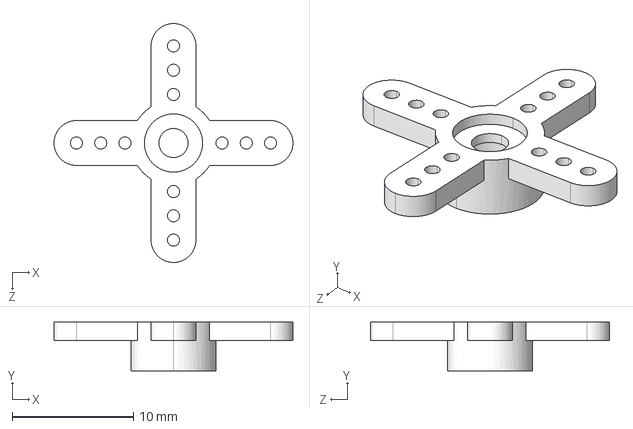
[picture p31: CAD file, 2026-06-11]
mechanical/CAD/Final/00_마이크로 서보_혼 십자.STEP
19.7 x 4.00 x 19.7 mm
