of-dandelions-and-daisies/basics-of-mechatronics/mechanical/CAD/Final/LCD_1602.SLDPRT

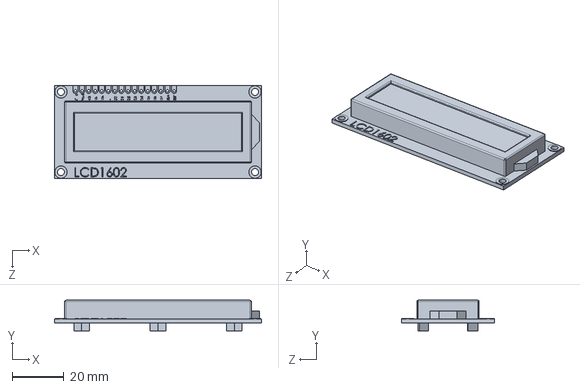
[picture p32: CAD file, 2026-06-11]
mechanical/CAD/Final/LCD_1602.SLDPRT
80.0 x 11.8 x 36.0 mm
