of-dandelions-and-daisies/basics-of-mechatronics/mechanical/CAD/Final/Interrupt Sensor.step

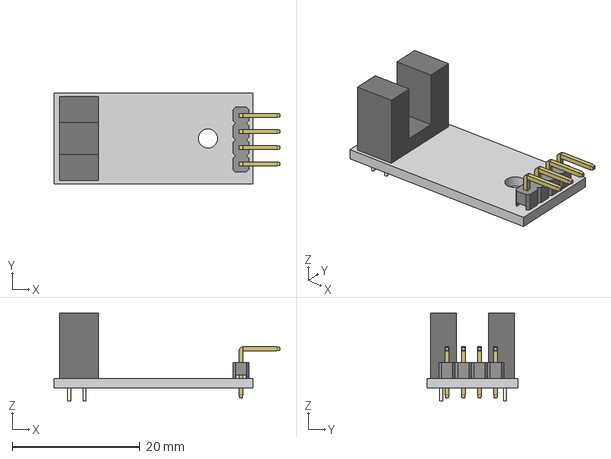
[picture p33: CAD file, 2026-06-11]
mechanical/CAD/Final/Interrupt Sensor.step
35.4 x 14.3 x 13.8 mm
Base, 2.54 mm Male Header Dupont Pins, Configurable_1X4
Pin, 2.54 mm Male Header Dupont Pins, Configurable x 4
