of-dandelions-and-daisies/basics-of-mechatronics/mechanical/CAD/Final/Shooter.stl

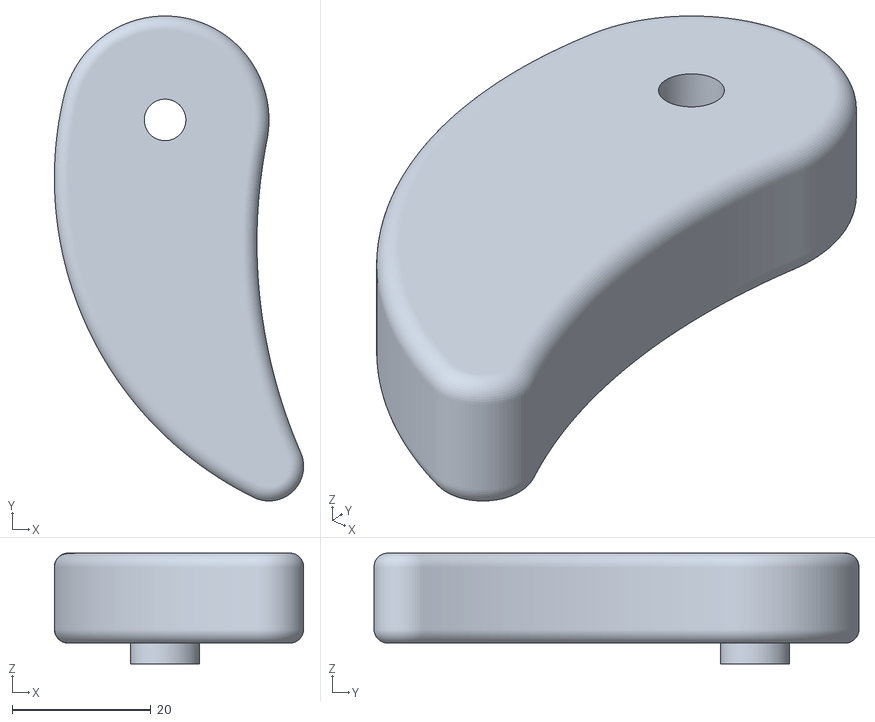
[picture p34: CAD file, 2026-06-11]
mechanical/CAD/Final/Shooter.stl
36.0 x 70.0 x 16.0
