of-dandelions-and-daisies/basics-of-mechatronics/mechanical/CAD/Final/Part1.stl

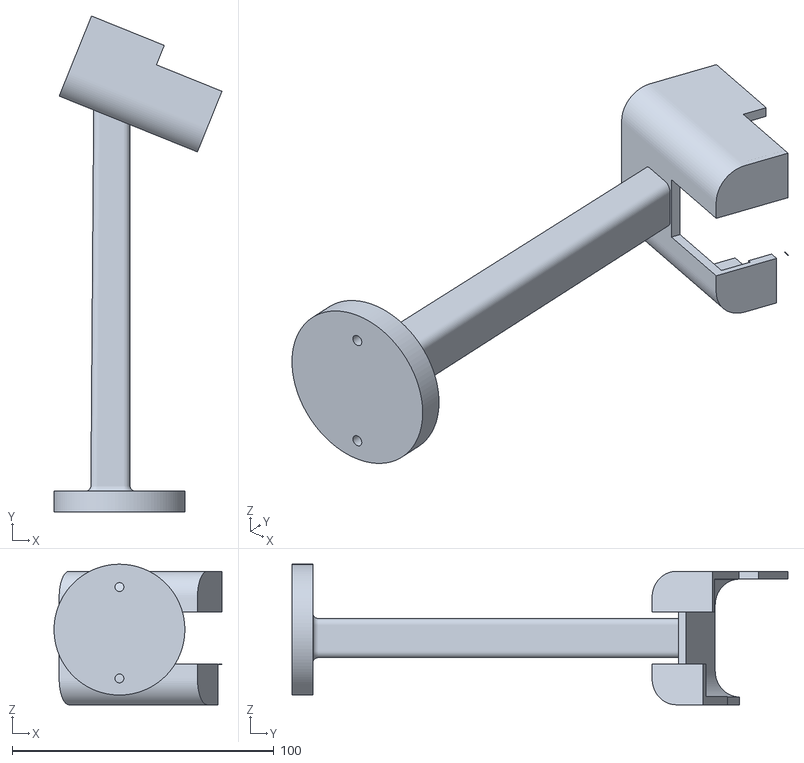
[picture p35: CAD file, 2026-06-11]
mechanical/CAD/Final/Part1.stl
64.2 x 189.5 x 53.7
