of-dandelions-and-daisies/basics-of-mechatronics/mechanical/CAD/Final/PushButtonSwitch.step

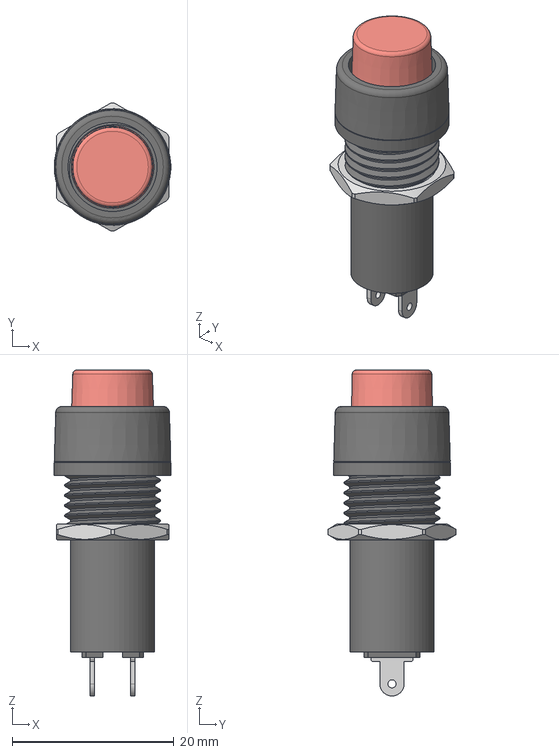
[picture p36: CAD file, 2026-06-11]
mechanical/CAD/Final/PushButtonSwitch.step
14.4 x 15.8 x 40.2 mm
