of-dandelions-and-daisies/basics-of-mechatronics/mechanical/CAD/Final/Cover of Sensors.stl

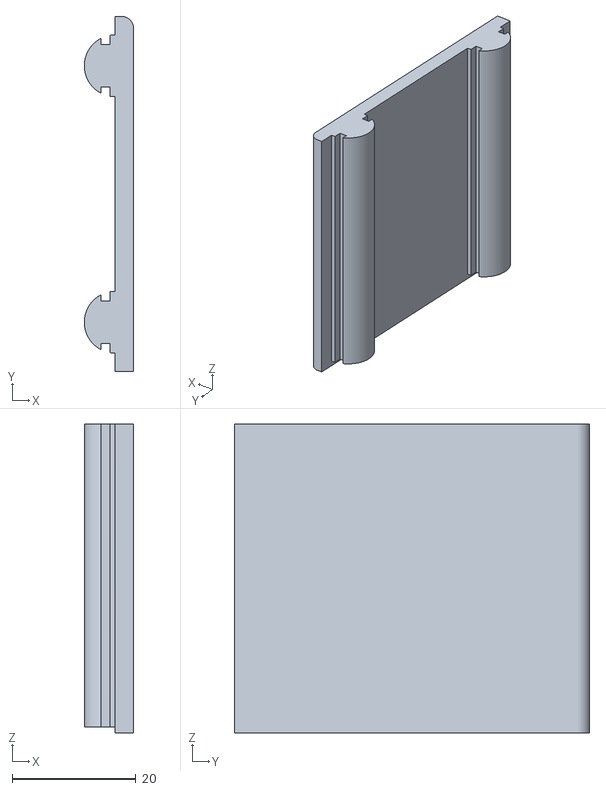
[picture p37: CAD file, 2026-06-11]
mechanical/CAD/Final/Cover of Sensors.stl
8.00 x 57.5 x 50.0
