of-dandelions-and-daisies/basics-of-mechatronics/mechanical/CAD/Final/PushButtonSwitchButton.step

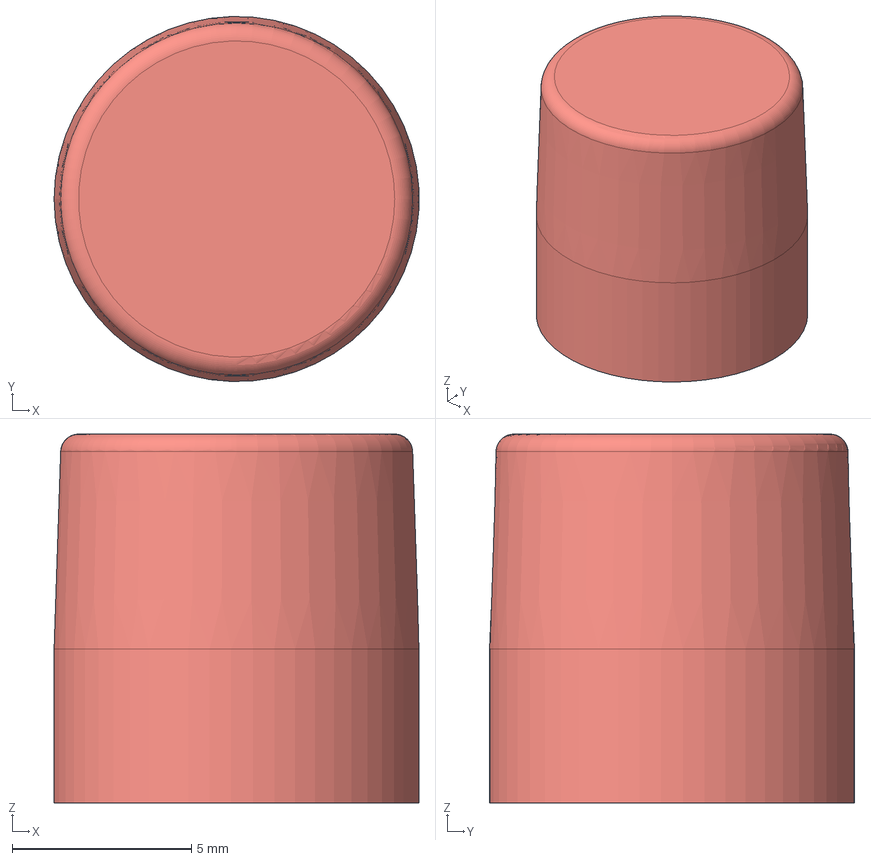
[picture p38: CAD file, 2026-06-11]
mechanical/CAD/Final/PushButtonSwitchButton.step
10.2 x 10.2 x 10.3 mm
