of-dandelions-and-daisies/basics-of-mechatronics/mechanical/CAD/Final/path.stl

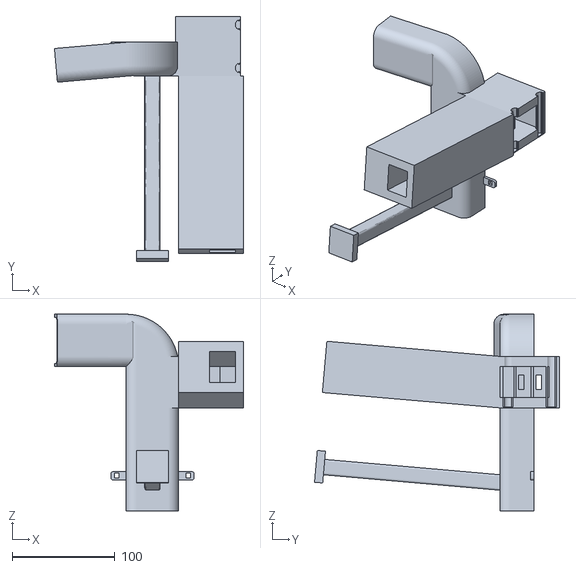
[picture p39: CAD file, 2026-06-11]
mechanical/CAD/Final/path.stl
183.7 x 238.0 x 191.0
