of-dandelions-and-daisies/basics-of-mechatronics/mechanical/CAD/Final/Path (from sorting to storage).stl

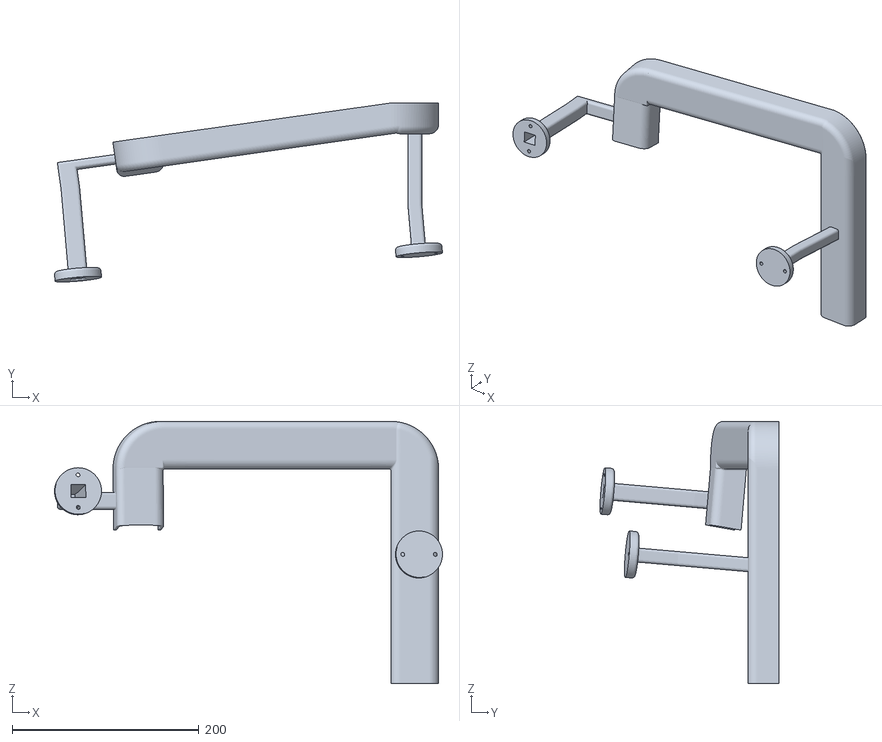
[picture p40: CAD file, 2026-06-11]
mechanical/CAD/Final/Path (from sorting to storage).stl
415.8 x 191.8 x 281.0
