of-dandelions-and-daisies/basics-of-mechatronics/mechanical/CAD/Final/Small Ball.stl

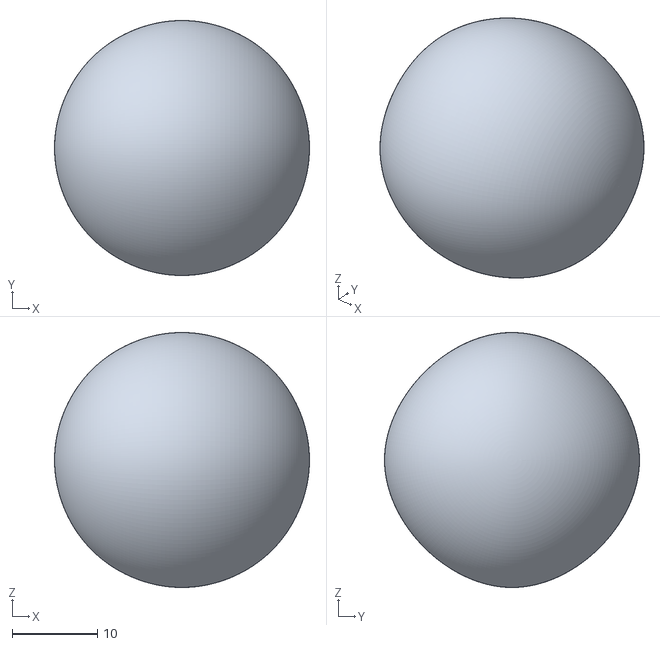
[picture p41: CAD file, 2026-06-11]
mechanical/CAD/Final/Small Ball.stl
30.0 x 30.0 x 30.0
