of-dandelions-and-daisies/basics-of-mechatronics/mechanical/CAD/Final/Base of Sorting.stl

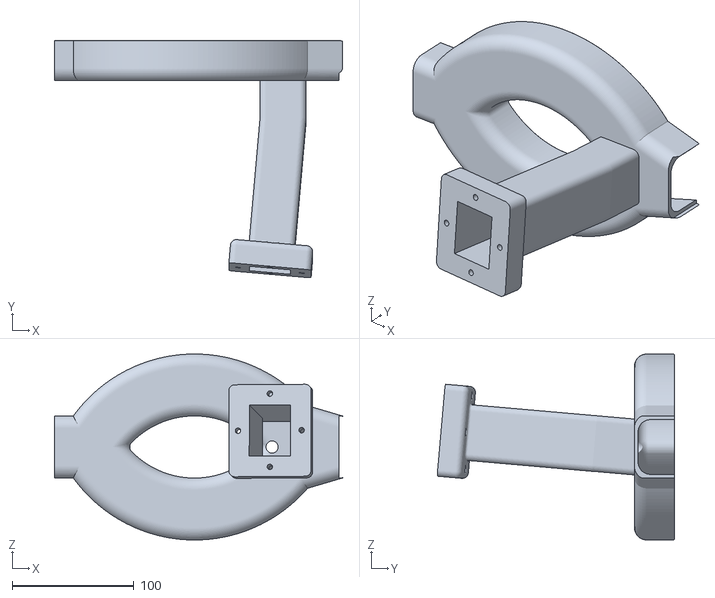
[picture p42: CAD file, 2026-06-11]
mechanical/CAD/Final/Base of Sorting.stl
237.0 x 195.2 x 153.1
