of-dandelions-and-daisies/basics-of-mechatronics/mechanical/CAD/Final/Basket Holder 2 .stl

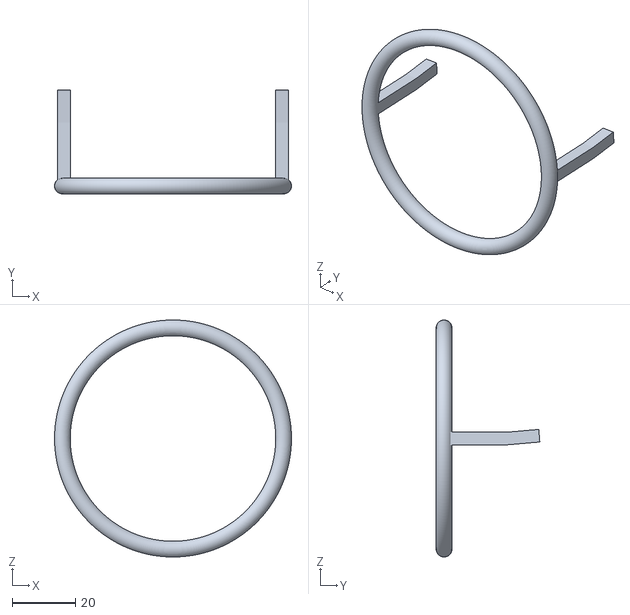
[picture p43: CAD file, 2026-06-11]
mechanical/CAD/Final/Basket Holder 2 .stl
75.0 x 32.8 x 75.0
