of-dandelions-and-daisies/basics-of-mechatronics/mechanical/CAD/Final/00_마이크로 서보_SG90.STEP

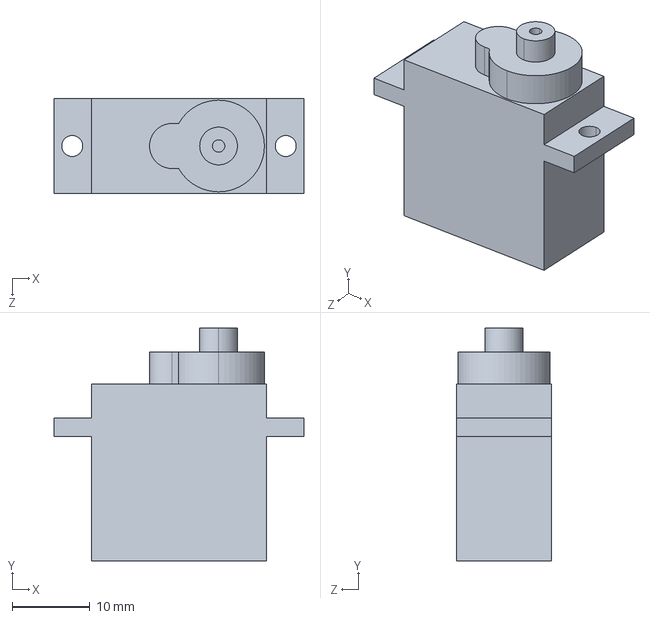
[picture p44: CAD file, 2026-06-11]
mechanical/CAD/Final/00_마이크로 서보_SG90.STEP
32.2 x 30.0 x 12.3 mm
