of-dandelions-and-daisies/basics-of-mechatronics/mechanical/CAD/Final/PushButtonSwitchNut.step

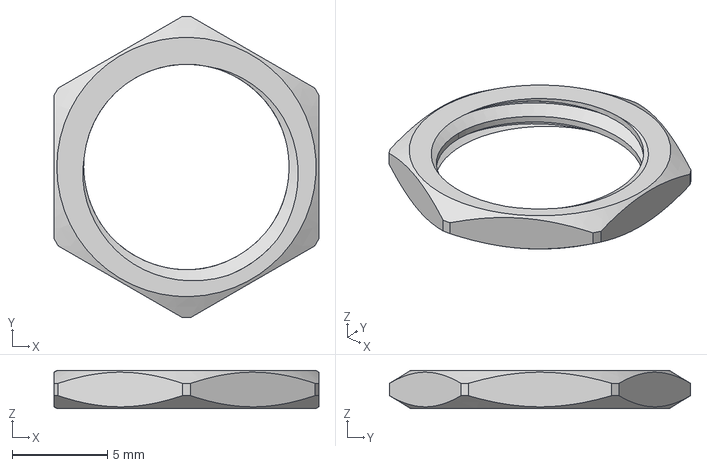
[picture p45: CAD file, 2026-06-11]
mechanical/CAD/Final/PushButtonSwitchNut.step
13.9 x 15.8 x 2.00 mm
