of-dandelions-and-daisies/basics-of-mechatronics/mechanical/CAD/Final/Big Ball.stl

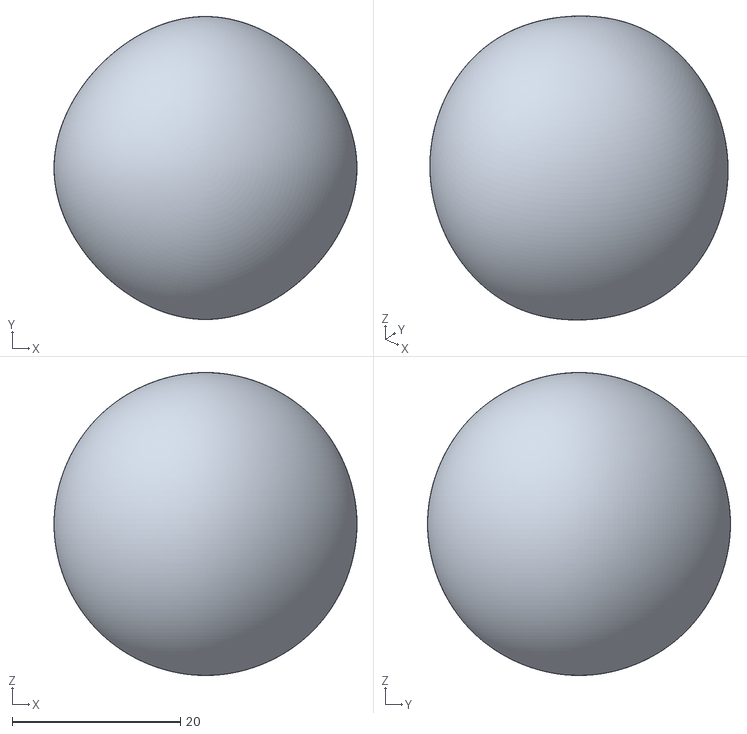
[picture p46: CAD file, 2026-06-11]
mechanical/CAD/Final/Big Ball.stl
36.0 x 36.0 x 36.0
