of-dandelions-and-daisies/basics-of-mechatronics/mechanical/CAD/Final/p2.stl

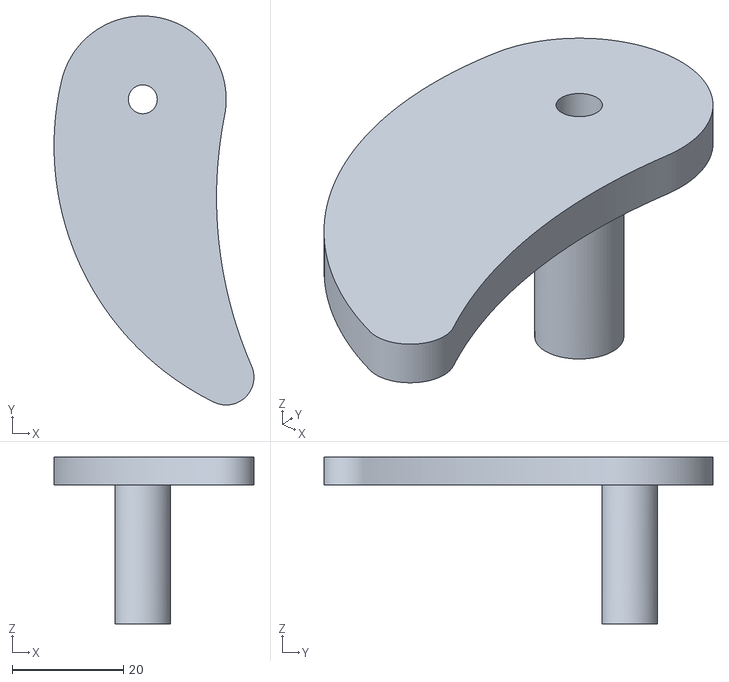
[picture p47: CAD file, 2026-06-11]
mechanical/CAD/Final/p2.stl
36.0 x 70.0 x 30.0
