of-dandelions-and-daisies/basics-of-mechatronics/(list of files, cad)

Other CAD files:
mechanical/CAD/Final/base.dwg
mechanical/CAD/Final/KCD4.step
mechanical/CAD/Final/00_마이크로 서보_SG90.ipt
mechanical/CAD/Final/2.54 mm crooked Male Header Dupont Pins, 90°, 1X4 v1 v1.iam
mechanical/CAD/Final/6000ZZ Ball.ipt
mechanical/CAD/Final/6000ZZ Inner ring.ipt
mechanical/CAD/Final/6000ZZ Outer ring.ipt
mechanical/CAD/Final/6000ZZ Shield1.ipt
mechanical/CAD/Final/6000ZZ Shield2.ipt
mechanical/CAD/Final/Ball Holder.ipt
mechanical/CAD/Final/Ball.ipt
mechanical/CAD/Final/Base Assembly.iam
mechanical/CAD/Final/Base of Sorting.ipt
mechanical/CAD/Final/Base, 2.54 mm Male Header Dupont Pins, Configurable_1X4.ipt
mechanical/CAD/Final/Base.ipt
mechanical/CAD/Final/Basket Holder 2 .ipt
mechanical/CAD/Final/Big Ball.ipt
mechanical/CAD/Final/Conveyor Belt.ipt
mechanical/CAD/Final/Conveyor Gear_DIN - Spur gear 2M 10T 14.5PA 20FW ---S10A75H50L5N.ipt
mechanical/CAD/Final/Cover of DC Housing.ipt
mechanical/CAD/Final/Cover of Sensors.ipt
mechanical/CAD/Final/DC - Gear Box Motor.ipt
mechanical/CAD/Final/Gate.ipt
mechanical/CAD/Final/Housing of Buttons & LCD.ipt
mechanical/CAD/Final/Housing of DC Motor.ipt
mechanical/CAD/Final/Housing of the motor.ipt
mechanical/CAD/Final/IR_LM393_pin.ipt
mechanical/CAD/Final/IR_LM393_pin/IR_LM393_pin/IR_LM393_pin.ipt
mechanical/CAD/Final/Interrupt Sensor.iam
mechanical/CAD/Final/Interrupt Sensor.ipt
mechanical/CAD/Final/KCD4/KCD4/KCD4.ipt
mechanical/CAD/Final/LCD_1602/LCD_1602/LCD_1602.ipt
mechanical/CAD/Final/Lifting Mechanism.iam
mechanical/CAD/Final/Lifting Mechanism.ipt
mechanical/CAD/Final/N Stand.ipt
mechanical/CAD/Final/NSK_6000ZZ.iam
mechanical/CAD/Final/OldVersions/Assembly of Sorting .0006.iam
mechanical/CAD/Final/OldVersions/Assembly13.0001.iam
mechanical/CAD/Final/OldVersions/Ball Holder.0001.ipt
mechanical/CAD/Final/OldVersions/Ball Holder.0002.ipt
mechanical/CAD/Final/OldVersions/Base Assembly.0038.iam
mechanical/CAD/Final/OldVersions/Base of Sorting.0014.ipt
mechanical/CAD/Final/OldVersions/Base.0006.ipt
mechanical/CAD/Final/OldVersions/Basket Assembly.0013.iam
mechanical/CAD/Final/OldVersions/Basket Holder 2 .0011.ipt
mechanical/CAD/Final/OldVersions/Big Ball.0001.ipt
mechanical/CAD/Final/OldVersions/Conveyor Gear_DIN - Spur gear 2M 10T 14.5PA 20FW ---S10A75H50L5N.0001.ipt
mechanical/CAD/Final/OldVersions/Conveyor Gear_DIN - Spur gear 2M 10T 14.5PA 20FW ---S10A75H50L5N.0002.ipt
mechanical/CAD/Final/OldVersions/Cover of DC Housing.0017.ipt
mechanical/CAD/Final/OldVersions/Cover of Sensors.0004.ipt
mechanical/CAD/Final/OldVersions/DC - Gear Box Motor.0001.ipt
mechanical/CAD/Final/OldVersions/DC - Gear Box Motor.0002.ipt
mechanical/CAD/Final/OldVersions/Gate.0016.ipt
mechanical/CAD/Final/OldVersions/Holder at shooting.0003.ipt
mechanical/CAD/Final/OldVersions/Housing of Buttons & LCD.0006.ipt
mechanical/CAD/Final/OldVersions/Housing of DC Motor.0019.ipt
mechanical/CAD/Final/OldVersions/Housing og Buttons & LCD.0002.ipt
mechanical/CAD/Final/OldVersions/Lifting Mechanism.0007.iam
mechanical/CAD/Final/OldVersions/N Stand.0001.ipt
mechanical/CAD/Final/OldVersions/N Stand.0002.ipt
mechanical/CAD/Final/OldVersions/Part1#2 .0005.ipt
mechanical/CAD/Final/OldVersions/Part1.0015.ipt
mechanical/CAD/Final/OldVersions/Part16.0002.ipt
mechanical/CAD/Final/OldVersions/Part1_sG90.0002.ipt
mechanical/CAD/Final/OldVersions/Part2.0004.ipt
mechanical/CAD/Final/OldVersions/Part2.0005.ipt
mechanical/CAD/Final/OldVersions/Part3.0001.ipt
mechanical/CAD/Final/OldVersions/Path (from sorting to storage).0015.ipt
mechanical/CAD/Final/OldVersions/Path from IR to PIN.0004.ipt
mechanical/CAD/Final/OldVersions/Path from Lifting to Shooting.0009.ipt
mechanical/CAD/Final/OldVersions/Plummer Block.0001.ipt
mechanical/CAD/Final/OldVersions/Plummer Block.0002.ipt
mechanical/CAD/Final/OldVersions/SHOOTING Assembly.0002.0029.iam
mechanical/CAD/Final/OldVersions/SORTING Assembly.0035.iam
mechanical/CAD/Final/OldVersions/Servo Gear_DIN - Spur gear 2M 10T 14.5PA 20FW ---S10A75H50L5N.0001.ipt
mechanical/CAD/Final/OldVersions/Servo Gear_DIN - Spur gear 2M 10T 14.5PA 20FW ---S10A75H50L5N.0002.ipt
mechanical/CAD/Final/OldVersions/Servo housing.0001.ipt
mechanical/CAD/Final/OldVersions/Servo housing.0010.ipt
mechanical/CAD/Final/OldVersions/Small Ball.0001.ipt
mechanical/CAD/Final/OldVersions/Sorting.0019.ipt
mechanical/CAD/Final/OldVersions/Stand of Shooting.0005.ipt
mechanical/CAD/Final/OldVersions/Stand of theme.0005.ipt
mechanical/CAD/Final/OldVersions/Storage Assembly.0003.iam
mechanical/CAD/Final/OldVersions/Storage Assembly.0011.iam
mechanical/CAD/Final/OldVersions/basket holder.0003.ipt
mechanical/CAD/Final/OldVersions/basket.0008.ipt
mechanical/CAD/Final/OldVersions/elevator.0001.ipt
mechanical/CAD/Final/OldVersions/elevator.0002.ipt
mechanical/CAD/Final/OldVersions/p1.0004.ipt
mechanical/CAD/Final/OldVersions/p2.0022.ipt
mechanical/CAD/Final/OldVersions/path.0031.ipt
mechanical/CAD/Final/Part1#2 .ipt
mechanical/CAD/Final/Part1.ipt
mechanical/CAD/Final/Part1_sG90.ipt
mechanical/CAD/Final/Part2.ipt
mechanical/CAD/Final/Part6.ipt
mechanical/CAD/Final/Path (from sorting to storage).ipt
mechanical/CAD/Final/Path from Lifting to Shooting.ipt
mechanical/CAD/Final/Pin, 2.54 mm Male Header Dupont Pins, Configurable.ipt
mechanical/CAD/Final/Plummer Block.ipt
mechanical/CAD/Final/Power-Switch_HS9-A3-04Q2B1-BR03/Power-Switch_HS9-A3-04Q2B1-BR03/Power-Switch_HS9-A3-04Q2B1-BR03.ipt
mechanical/CAD/Final/PushButtonSwitch.f3d
mechanical/CAD/Final/PushButtonSwitch/PushButtonSwitch/PushButtonSwitch.ipt
mechanical/CAD/Final/PushButtonSwitchWasher.step
mechanical/CAD/Final/SG90 - Micro Servo 9g - Tower Pro.1_Peça.ipt
mechanical/CAD/Final/SHOOTING Assembly.0002.iam
mechanical/CAD/Final/SORTING Assembly.iam
mechanical/CAD/Final/Servo Gear_DIN - Spur gear 2M 10T 14.5PA 20FW ---S10A75H50L5N.ipt
mechanical/CAD/Final/Servo housing.ipt
mechanical/CAD/Final/Small Ball.ipt
mechanical/CAD/Final/Sorting.ipt
mechanical/CAD/Final/Stand of Shooting.ipt
mechanical/CAD/Final/Stand of theme.ipt
mechanical/CAD/Final/Storage Assembly.iam
mechanical/CAD/Final/basket.ipt
mechanical/CAD/Final/elevator.ipt
mechanical/CAD/Final/encoder disk.SLDPRT
mechanical/CAD/Final/encoder disk.ipt
mechanical/CAD/Final/p2.ipt
mechanical/CAD/Final/path.ipt
