of-dandelions-and-daisies/basics-of-mechatronics/docs/WBS_Ball_Sorting_System.pdf

## BASICS OF MECHATRONICS — Interactive Kids Toy

Planning | Designing | Assembly | Integration | Modification

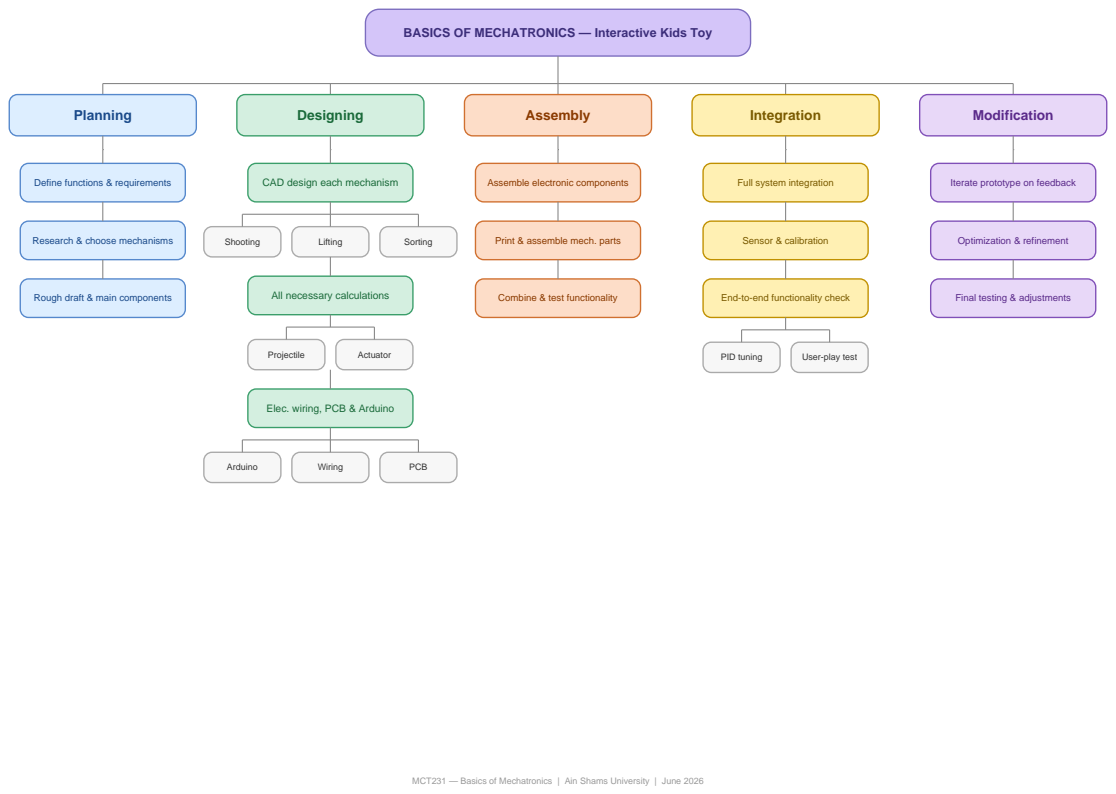
[picture p48: page 1]
Shooting; Lifting; Sorting; Projectile; Actuator; Arduino; Wiring; PCB; Sensor & calibration; PID tuning; User-play test; Optimization & refinement

Define functions & requirements

CAD design each mechanism

Assemble electronic components

Full system integration

Iterate prototype on feedback

Research & choose mechanisms

Print & assemble mech. parts

Rough draft & main components

All necessary calculations

Combine & test functionality

End-to-end functionality check

Final testing & adjustments

Elec. wiring, PCB & Arduino

MCT231 — Basics of Mechatronics | Ain Shams University | June 2026
