of-dandelions-and-daisies/basics-of-mechatronics/(list of files, drawings)

Other design files:
electrical/PCB1.PcbDoc
electrical/SB PCB - Copy.PrjPcb
electrical/Sheet1.SchDoc
