of-dandelions-and-daisies/basics-of-mechatronics/(commit log)

2026-06-10 Add mechanical directory for CAD exports and drawings
2026-06-10 Add electrical directory for schematics, PCB sources, and exports
2026-06-10 Create CAD folder for mechanical designs
2026-06-11 all final CAD files
    all final CAD files
    [00_마이크로 서보_SG90.STEP, 00_마이크로 서보_SG90.ipt, 00_마이크로 서보_혼 십자.STEP, 2.54 mm crooked Male Header Dupont Pins, 90°, 1X4 v1 v1.iam, 6000ZZ Ball.ipt, 6000ZZ Inner ring.ipt, 6000ZZ Outer ring.ipt, 6000ZZ Shield1.ipt]
2026-06-11 Add firmware for Arduino-based toy dispenser
2026-06-11 Add I2C slave firmware for lift, sorter, and shooter
    This file contains the implementation of an I2C slave device with functionalities for lifting, sorting, and shooting mechanisms. It includes PID control for the shooter and integrates various sensors for operation.
